viric/smartcitizen-kit-21/hardware/SCK_URBAN_BOARD_2.1/SCK_URBAN_SHIELD_2.1rev_a.sch

## EAGLE design hardware/SCK_URBAN_BOARD_2.1/SCK_URBAN_SHIELD_2.1rev_a.sch (2020-02-14)

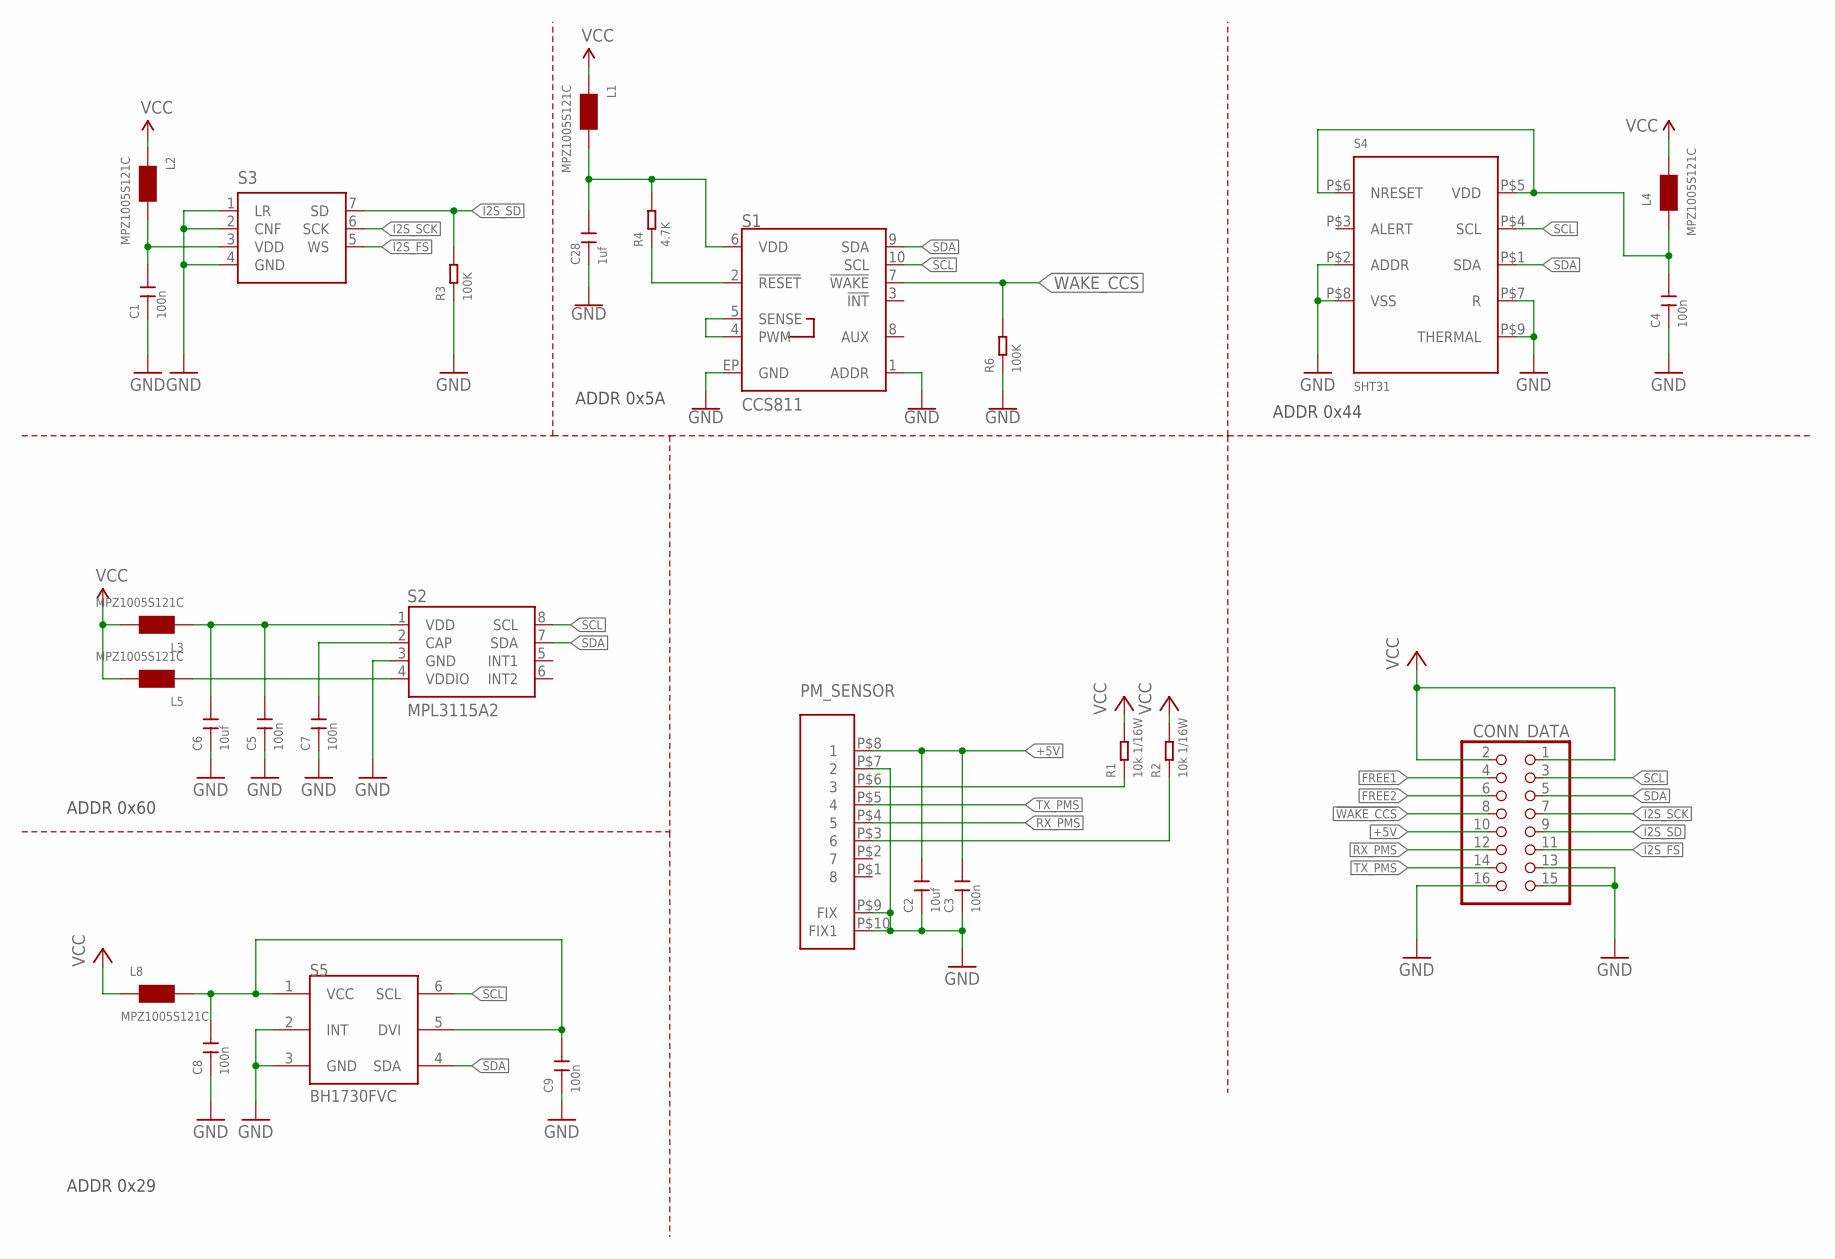
[picture p1: schematic SCK_URBAN_SHIELD_2.1rev_a.sch]

Parts:
C1, C3, C4, C5, C7, C8, C9: 100n; C0402
C2, C6: 10uf; C0603
C28: 1uf; C0805
CONN_DATA: PINHD_2X8MAL_SMD; PINHD_2X8_SMD_MALE_UNHOLED
L1, L2, L3, L4, L5, L8: MPZ1005S121C; 0402
PM_SENSOR: MOLEX_53261-0871_8PIN_RECT; MOLEX_PICOBLADE_90ANGLE_8PIN
R1, R2: 10k 1/16W; R0402
R3, R6: 100K; R0402
R4: 4.7K; R0402
S1: CCS811; LGA10
S2: MPL3115A2
S3: ICS-43432
S4: SHT31; DFN8_STH3X-DIS
S5: BH1730FVC; WSOF6

Connections:
!RST: R4.1, S1.2 (!RESET!)
!WAKE_CCS: CONN_DATA.8, R6.2, S1.7 (!WAKE!)
+5V: C2.2, C3.2, CONN_DATA.10, PM_SENSOR.P$8 (1)
FREE1: CONN_DATA.4
FREE2: CONN_DATA.6
GND: C1.1, C2.1, C3.1, C4.1, C5.1, C6.1, C7.1, C8.1, C9.1, C28.1, CONN_DATA.13, CONN_DATA.15, CONN_DATA.16, PM_SENSOR.P$7 (2), PM_SENSOR.P$9 (FIX), PM_SENSOR.P$10 (FIX1), R3.1, R6.1, S1.1 (ADDR), S1.EP (GND), S2.3 (GND), S3.1 (LR), S3.2 (CNF), S3.4 (GND), S4.P$2 (ADDR), S4.P$7 (R), S4.P$8 (VSS), S4.P$9 (THERMAL), S5.2 (INT), S5.3 (GND)
I2S_FS: CONN_DATA.11, S3.5 (WS)
I2S_SCK: CONN_DATA.7, S3.6 (SCK)
I2S_SD: CONN_DATA.9, R3.2, S3.7 (SD)
unnamed: C7.2, S2.2 (CAP)
unnamed: C8.2, C9.2, L8.2, S5.1 (VCC), S5.5 (DVI)
unnamed: C4.2, L4.2, S4.P$5 (VDD), S4.P$6 (NRESET)
unnamed: C28.2, L1.2, R4.2, S1.6 (VDD)
unnamed: L5.1, S2.4 (VDDIO)
unnamed: C5.2, C6.2, L3.1, S2.1 (VDD)
unnamed: PM_SENSOR.P$6 (3), R1.1
unnamed: PM_SENSOR.P$3 (6), R2.1
unnamed: C1.2, L2.2, S3.3 (VDD)
NTC_SENSE: S1.4 (PWM), S1.5 (SENSE)
RX_PMS: CONN_DATA.12, PM_SENSOR.P$4 (5)
SCL: CONN_DATA.3, S1.10 (SCL), S2.8 (SCL), S4.P$4 (SCL), S5.6 (SCL)
SDA: CONN_DATA.5, S1.9 (SDA), S2.7 (SDA), S4.P$1 (SDA), S5.4 (SDA)
TX_PMS: CONN_DATA.14, PM_SENSOR.P$5 (4)
VCC: CONN_DATA.1, CONN_DATA.2, L1.1, L2.1, L3.2, L4.1, L5.2, L8.1, R1.2, R2.2

Notes on the sheet:
ADDR 0x44
ADDR 0x60
ADDR 0x29
ADDR 0x5A
