viric/smartcitizen-kit-21/sam/src/SckUrban.cpp

#include "SckUrban.h"
#include "SckBase.h"

// Hardware Serial UART PM
Uart SerialPM (&sercom5, pinPM_SERIAL_RX, pinPM_SERIAL_TX, SERCOM_RX_PAD_1, UART_TX_PAD_0);
void SERCOM5_Handler() {
	SerialPM.IrqHandler();
}

bool SckUrban::setup()
{
	if (!sck_bh1730fvc.start()) return false;
	if (!sck_sht31.start()) return false;
	if (!sck_noise.start()) return false;
	if (!sck_mpl3115A2.start()) return false;
	if (!sck_ccs811.start()) return false;
	sck_pm.start(); // This sensor is independent of the urban board. That's way we don't declare error if it's not there.

	return true;
};
bool SckUrban::start(SensorType wichSensor)
{
	switch(wichSensor) {
		case SENSOR_LIGHT: 				if (sck_bh1730fvc.start()) return true; break;
		case SENSOR_TEMPERATURE:
		case SENSOR_HUMIDITY: 				if (sck_sht31.start()) return true; break;
		case SENSOR_NOISE_DBA:
		case SENSOR_NOISE_DBC:
		case SENSOR_NOISE_DBZ:
		case SENSOR_NOISE_FFT: 				if (sck_noise.start()) return true; break;
		case SENSOR_ALTITUDE:
		case SENSOR_PRESSURE:
		case SENSOR_PRESSURE_TEMP: 			if (sck_mpl3115A2.start()) return true; break;
		case SENSOR_CCS811_VOCS:			return sck_ccs811.start(); break;
		case SENSOR_CCS811_ECO2: 			return sck_ccs811.start(); break;
		case SENSOR_PM_1:
		case SENSOR_PM_25:
		case SENSOR_PM_10:
		case SENSOR_PN_03:
		case SENSOR_PN_05:
		case SENSOR_PN_1:
		case SENSOR_PN_25:
		case SENSOR_PN_5:
		case SENSOR_PN_10: 				if (sck_pm.start()) return true; break;
		default: break;
	}

	return false;
}
bool SckUrban::stop(SensorType wichSensor)
{
	switch(wichSensor) {
		case SENSOR_LIGHT: 				if (sck_bh1730fvc.stop()) return true; break;
		case SENSOR_TEMPERATURE:
		case SENSOR_HUMIDITY: 				if (sck_sht31.stop()) return true; break;
		case SENSOR_NOISE_DBA:
		case SENSOR_NOISE_DBC:
		case SENSOR_NOISE_DBZ:
		case SENSOR_NOISE_FFT: 				if (sck_noise.stop()) return true;
		case SENSOR_ALTITUDE:
		case SENSOR_PRESSURE:
		case SENSOR_PRESSURE_TEMP: 			if (sck_mpl3115A2.stop()) return true; break;
		case SENSOR_CCS811_VOCS:			return sck_ccs811.stop(); break;
		case SENSOR_CCS811_ECO2: 			return sck_ccs811.stop(); break;
		case SENSOR_PM_1:
		case SENSOR_PM_25:
		case SENSOR_PM_10:
		case SENSOR_PN_03:
		case SENSOR_PN_05:
		case SENSOR_PN_1:
		case SENSOR_PN_25:
		case SENSOR_PN_5:
		case SENSOR_PN_10: 				if (sck_pm.stop()) return true; break;
		default: break;
	}

	return false;
}

void SckUrban::getReading(SckBase *base, OneSensor *wichSensor)
{
	wichSensor->state = 0;
	switch(wichSensor->type) {
		case SENSOR_LIGHT:			if (sck_bh1730fvc.get()) 			{ wichSensor->reading = String(sck_bh1730fvc.reading); return; } break;
		case SENSOR_TEMPERATURE: 		if (sck_sht31.getReading()) 			{ wichSensor->reading = String(sck_sht31.temperature); return; } break;
		case SENSOR_HUMIDITY: 			if (sck_sht31.getReading()) 			{ wichSensor->reading = String(sck_sht31.humidity); return; } break;
		case SENSOR_NOISE_DBA: 			if (sck_noise.getReading(SENSOR_NOISE_DBA)) 	{ wichSensor->reading = String(sck_noise.readingDB); return; } break;
		case SENSOR_NOISE_DBC: 			if (sck_noise.getReading(SENSOR_NOISE_DBC)) 	{ wichSensor->reading = String(sck_noise.readingDB); return; } break;
		case SENSOR_NOISE_DBZ: 			if (sck_noise.getReading(SENSOR_NOISE_DBZ)) 	{ wichSensor->reading = String(sck_noise.readingDB); return; } break;
		case SENSOR_NOISE_FFT: 			if (sck_noise.getReading(SENSOR_NOISE_FFT)) 	{
								// TODO find a way to give access to readingsFFT instead of storing them on a String (too much RAM)
								// For now it just prints the values to console
								for (uint16_t i=1; i<sck_noise.FFT_NUM; i++) SerialUSB.println(sck_noise.readingFFT[i]);
								return;
							}
		case SENSOR_CCS811_VOCS:		if (sck_ccs811.getReading(base)) 		{ wichSensor->reading = String(sck_ccs811.VOCgas); return; } break;
		case SENSOR_CCS811_ECO2:		if (sck_ccs811.getReading(base)) 		{ wichSensor->reading = String(sck_ccs811.ECO2gas); return; } break;
		case SENSOR_ALTITUDE:			if (sck_mpl3115A2.getAltitude()) 		{ wichSensor->reading = String(sck_mpl3115A2.altitude); return; } break;
		case SENSOR_PRESSURE:			if (sck_mpl3115A2.getPressure()) 		{ wichSensor->reading = String(sck_mpl3115A2.pressure); return; } break;
		case SENSOR_PRESSURE_TEMP:		if (sck_mpl3115A2.getTemperature()) 		{ wichSensor->reading = String(sck_mpl3115A2.temperature); return; } break;
		case SENSOR_PM_1: 			wichSensor->state = sck_pm.oneShot(sck_pm.oneShotPeriod); if (wichSensor->state == -1) break; if (wichSensor->state == 0) wichSensor->reading = String(sck_pm.pm1); return;
		case SENSOR_PM_25: 			wichSensor->state = sck_pm.oneShot(sck_pm.oneShotPeriod); if (wichSensor->state == -1) break; if (wichSensor->state == 0) wichSensor->reading = String(sck_pm.pm25); return;
		case SENSOR_PM_10: 			wichSensor->state = sck_pm.oneShot(sck_pm.oneShotPeriod); if (wichSensor->state == -1) break; if (wichSensor->state == 0) wichSensor->reading = String(sck_pm.pm10); return;
		case SENSOR_PN_03: 			wichSensor->state = sck_pm.oneShot(sck_pm.oneShotPeriod); if (wichSensor->state == -1) break; if (wichSensor->state == 0) wichSensor->reading = String(sck_pm.pn03); return;
		case SENSOR_PN_05: 			wichSensor->state = sck_pm.oneShot(sck_pm.oneShotPeriod); if (wichSensor->state == -1) break; if (wichSensor->state == 0) wichSensor->reading = String(sck_pm.pn05); return;
		case SENSOR_PN_1: 			wichSensor->state = sck_pm.oneShot(sck_pm.oneShotPeriod); if (wichSensor->state == -1) break; if (wichSensor->state == 0) wichSensor->reading = String(sck_pm.pn1); return;
		case SENSOR_PN_25: 			wichSensor->state = sck_pm.oneShot(sck_pm.oneShotPeriod); if (wichSensor->state == -1) break; if (wichSensor->state == 0) wichSensor->reading = String(sck_pm.pn25); return;
		case SENSOR_PN_5: 			wichSensor->state = sck_pm.oneShot(sck_pm.oneShotPeriod); if (wichSensor->state == -1) break; if (wichSensor->state == 0) wichSensor->reading = String(sck_pm.pn5); return;
		case SENSOR_PN_10: 			wichSensor->state = sck_pm.oneShot(sck_pm.oneShotPeriod); if (wichSensor->state == -1) break; if (wichSensor->state == 0) wichSensor->reading = String(sck_pm.pn10); return;
		default: break;
	}
	wichSensor->reading = "null";
	wichSensor->state = -1;
}
bool SckUrban::control(SckBase *base, SensorType wichSensor, String command)
{

	switch (wichSensor) {
		case SENSOR_NOISE_DBA:
		case SENSOR_NOISE_DBC:
		case SENSOR_NOISE_DBZ:
		case SENSOR_NOISE_FFT:
		{
				if (command.startsWith("debug")) {
					sck_noise.debugFlag = !sck_noise.debugFlag;
					sprintf(base->outBuff, "Noise debug: %s", sck_noise.debugFlag  ? "true" : "false");
					base->sckOut();
					return true;
				}
				break;
		}
		case SENSOR_CCS811_VOCS:
		case SENSOR_CCS811_ECO2:
		{
				if (command.startsWith("compensate")) {
					base->config.extra.ccsCompensate = !base->config.extra.ccsCompensate;
					sprintf(base->outBuff, "compensate set to: %s",
                            base->config.extra.ccsCompensate ? "true" : "false");
					base->sckOut();
					return true;
				} else if (command.startsWith("mode")) {
				
					command.replace("mode", "");
					command.trim();

					if (command.length() == 0) {
						sprintf(base->outBuff, "Current drive mode: %u", sck_ccs811.driveMode);
						base->sckOut();
						return "true";
					}

					uint8_t newDriveMode = command.toInt();
					if ((newDriveMode == 0 and !command.equals("0")) || newDriveMode > 4 || newDriveMode < 0) return F("Wrong drive mode value received, try again");

					//Mode 0 = Idle
					//Mode 1 = read every 1s
					//Mode 2 = every 10s
					//Mode 3 = every 60s
					//Mode 4 = RAW mode
					if (sck_ccs811.setDriveMode(newDriveMode) != CCS811Core::CCS811_Stat_SUCCESS) return F("Failed to set new drive mode");
					else return String F("Drivemode set to ") + String(sck_ccs811.driveMode);
					
				} else if (command.startsWith("baseline")) {
					command.replace("baseline", "");
					command.trim();

					uint16_t newbaseline = strtol(command.c_str(), 0, 16);
					bool ok = sck_ccs811.setBaseline(newbaseline);
					if (ok) {
						sprintf(base->outBuff, "New baseline set: 0x%x", newbaseline);
						base->sckOut();
					} else {
						sprintf(base->outBuff, "Error setting baseline: 0x%x", newbaseline);
						base->sckOut();
					}
					return true;
				} else if (command.startsWith("status")) {
					uint8_t major, minor, trivial;
					bool ok = sck_ccs811.getFWAppVersion(&major, &minor, &trivial);
					if (ok) {
						sprintf(base->outBuff, "fw app version: %u.%u.%u",
								major, minor, trivial);
						base->sckOut();
					} else {
						sprintf(base->outBuff, "fw app version: failed");
						base->sckOut();
					}
					sprintf(base->outBuff, "mode: %i",
                            sck_ccs811.driveMode);
					base->sckOut();
					sprintf(base->outBuff, "run-in passed: %s",
							base->getRuninPassed() ? "true":"false");
					base->sckOut();
					sprintf(base->outBuff, "getBaseline: 0x%hx",
                            sck_ccs811.getBaseline());
					base->sckOut();
					uint8_t errorcode;
					bool statusError = sck_ccs811.getStatusError(&errorcode);
					if (statusError) {
						sprintf(base->outBuff, "status error: error 0x%x",
								errorcode);
						base->sckOut();
					} else {
						sprintf(base->outBuff, "status error: no error");
						base->sckOut();
					}

					sprintf(base->outBuff, "compensate: %s",
							base->config.extra.ccsCompensate ? "true" : "false");
					base->sckOut();
					return true;
				} else if (command.startsWith("help") || command.length() == 0) {
				
					sprintf(base->outBuff, "Available commands:\r\n"
                            "* compensate (toggles temp/hum compensation)\r\n"
                            "* mode [0-4] (0-idle, 1-1s, 2-10s, 3-60s, 4-raw)\r\n"
                            "* baseline XXXX (set baseline to hex num)\r\n"
                            "* status");
					base->sckOut();
					return true;
				}
			break;
		}
		default: break;
	}

	base->sckOut("Sensor not recognized!!");
	return false;
}

// Light
bool Sck_BH1730FVC::start()
{
	if (!I2Cdetect(&Wire, address)) return false;
	return true;
}
bool Sck_BH1730FVC::stop()
{
	// 0x00 register - CONTROL
	uint8_t CONTROL = B000000;
	// ADC_INTR: 	5	0:Interrupt is inactive.
	// 			1:Interrupt is active.
	// ADC_VALID:	4	0:ADC data is not updated after last reading.
	// 			1:ADC data is updated after last reading.
	// ONE_TIME:	3	0:ADC measurement is continuous.
	// 			1:ADC measurement is one time.
	// 			ADC	transits to power down automatically.
	// DATA_SEL:	2	0:ADC measurement Type0 and Type1.
	// 			1:ADC measurement Type0 only.
	// ADC_EN:	1	0:ADC measurement stop.
	// 			1:ADC measurement start.
	// POWER:	0	0:ADC power down.
	// 			1:ADC power on.

	// Send Configuration
	// This will save around 150 uA
	Wire.beginTransmission(address);
	Wire.write(0x80);
	Wire.write(CONTROL);
	Wire.endTransmission();

	return true;
}
bool Sck_BH1730FVC::updateValues()
{
	// Datasheet http://rohmfs.rohm.com/en/products/databook/datasheet/ic/sensor/light/bh1730fvc-e.pdf

	// 0x00 register - CONTROL
	uint8_t CONTROL = B000011;
	// ADC_INTR: 	5	0:Interrupt is inactive.
	// 			1:Interrupt is active.
	// ADC_VALID:	4	0:ADC data is not updated after last reading.
	// 			1:ADC data is updated after last reading.
	// ONE_TIME:	3	0:ADC measurement is continuous.
	// 			1:ADC measurement is one time.
	// 			ADC	transits to power down automatically.
	// DATA_SEL:	2	0:ADC measurement Type0 and Type1.
	// 			1:ADC measurement Type0 only.
	// ADC_EN:	1	0:ADC measurement stop.
	// 			1:ADC measurement start.
	// POWER:	0	0:ADC power down.
	// 			1:ADC power on.

	// 0x01 register - TIMMING
	// uint8_t ITIME  = 0xDA; 	// Datasheet default value (218 DEC)

	// 00h: Start / Stop of measurement is set by special command. (ADC manual integration mode)
	// 01h to FFh: Integration time is determined by ITIME value (defaultt is oxDA)
	// Integration Time : ITIME_ms = Tint * 964 * (256 - ITIME)
	// Measurement time : Tmt= ITIME_ms + Tint * 714

	// 0x02 register - INTERRUPT
	uint8_t INTERRUPT = B00000000;
	// RES 		7 	Write 0
	// INT_STOP	6	0 : ADC measurement does not stop.
	// 				1 : ADC measurement stops and transits to power down mode when interrupt becomes active.
	// RES 		5 	Write 0
	// INT_EN 	4 	0 : Disable interrupt function.
	// 				1 : Enable interrupt function.
	// PERSIST 	3:0 Interrupt persistence function.
	//	0000 : Interrupt becomes active at each measurement end.
	//	0001 : Interrupt status is updated at each measurement end.
	//	0010 : Interrupt status is updated if two consecutive threshold judgments are the same.
	//	When  set  0011  or  more,  interrupt  status  is  updated  if same threshold judgments continue consecutively same times as the number set in PERSIST.

	// 0x03, 0x04 registers - TH_LOW Low interrupt threshold
	uint8_t TH_LOW0 = 0x00;		// Lower byte of low interrupt threshold
	uint8_t TH_LOW1 = 0x00;		// Upper byte of low interrupt threshold

	// 0x05, 0x06 registers - TH_UP High interrupt threshold
	uint8_t TH_UP0 = 0xFF;		// Lower byte of high interrupt threshold
	uint8_t TH_UP1 = 0xFF;		// Upper byte of high interrupt threshold

	// 0x07 - GAIN
	uint8_t GAIN = 0x00;
	// GAIN  2:0	ADC resolution setting
	//	  X00 : x1 gain mode
	//	  X01 : x2 gain mode
	//	  X10 : x64 gain mode
	//	  X11 : x128 gain mode

	uint8_t DATA[8] = {CONTROL, ITIME, INTERRUPT, TH_LOW0, TH_LOW1, TH_UP0, TH_UP1, GAIN};

	// Send Configuration
	Wire.beginTransmission(address);
	Wire.write(0x80);
	for (int i= 0; i<8; i++) Wire.write(DATA[i]);
	Wire.endTransmission();

	// Calculate timming values
	ITIME_ms = (Tint * 964 * (256 - ITIME)) / 1000;
	Tmt =  ITIME_ms + (Tint * 714);

	// Wait for ADC to finish
	uint32_t started = millis();
	uint8_t answer = 0;
	while ((answer & 0x10) == 0) {
		delay(10);
		Wire.beginTransmission(address);
		Wire.write(0x80);
		Wire.endTransmission();
		Wire.requestFrom(address, 1);
		answer = Wire.read();
		if (millis() - started > Tmt) {
			if (debug) SerialUSB.println("ERROR: Timeout waiting for reading");
			return false;
		}
	}

	// Ask for reading
	Wire.beginTransmission(address);
	Wire.write(0x94);
	Wire.endTransmission();
	Wire.requestFrom(address, 4);

	// Get result
	uint16_t IDATA0 = 0;
	uint16_t IDATA1 = 0;
	IDATA0 = Wire.read();
	IDATA0 = IDATA0 | (Wire.read()<<8);
	IDATA1 = Wire.read();
	IDATA1 = IDATA1 | (Wire.read()<<8);
	DATA0 = (float)IDATA0;
	DATA1 = (float)IDATA1;

	// Setup gain
	Gain = 1;
	if (GAIN == 0x01) Gain = 2;
	else if (GAIN == 0x02) Gain = 64;
	else if (GAIN == 0x03) Gain = 128;

	return true;
}
bool Sck_BH1730FVC::get()
{
	// Start in the default integration time
	ITIME = 218;

	if (!updateValues()) return false;

	// Adjust the Integration Time (ITIME)
	for (uint8_t i=0; i<6; i++) {

		if (DATA0 > goUp || DATA1 > goUp) {
			ITIME += (((ITIME_max - ITIME) / 2) + 1);
			if (ITIME > 250) ITIME = ITIME_max;

			if (debug) {
				SerialUSB.print(DATA0);
				SerialUSB.print(" -- ");
				SerialUSB.print(DATA1);
				SerialUSB.print(" >> ");
				SerialUSB.println(ITIME);
			}
		} else break;

		if (!updateValues()) return false;
	}

	// Lux calculation (Datasheet page 13)
	float Lx = 0;
	if (DATA0 > 0 && DATA1 > 0) {
		if (DATA1/DATA0 < 0.26) Lx = ((1.290 * DATA0 - 2.733 * DATA1) / Gain) * (102.6 / ITIME_ms);
		else if (DATA1/DATA0 < 0.55) Lx = ((0.795 * DATA0 - 0.859 * DATA1) / Gain) * (102.6 / ITIME_ms);
		else if (DATA1/DATA0 < 1.09) Lx = ((0.510 * DATA0 - 0.345 * DATA1) / Gain) * (102.6 / ITIME_ms);
		else if (DATA1/DATA0 < 2.13) Lx = ((0.276 * DATA0 - 0.130 * DATA1) / Gain) * (102.6 / ITIME_ms);
		else Lx = 0;
	}

	Lx = max(0, Lx);
	reading  = (int)Lx;

	if (debug) {
		SerialUSB.print("Integration Time ITIME_ms: ");
		SerialUSB.println(ITIME_ms);
		SerialUSB.print("Measurement Time Tmt: ");
		SerialUSB.println(Tmt);
		SerialUSB.print("Gain: ");
		SerialUSB.println(Gain);
		SerialUSB.print("Visible Light DATA0: ");
		SerialUSB.println(DATA0);
		SerialUSB.print("Infrared Light DATA1: ");
		SerialUSB.println(DATA1);
		SerialUSB.print("Calculated Lux: ");
		SerialUSB.println(Lx);
	}

	stop();

	return true;
}

// SHT31 (Temperature and Humidity)
// TODO Implement calibration routine
// TODO implement heater controller
Sck_SHT31::Sck_SHT31(TwoWire *localWire)
{
	_Wire = localWire;
}
bool Sck_SHT31::start()
{
	_Wire->begin();
	_Wire->beginTransmission(address);
	byte error = _Wire->endTransmission();
	if (error != 0) return false;

	delay(1); 		// In case the device was off
	sendComm(SOFT_RESET); 	// Send reset command
	delay(50); 		// Give time to finish reset
	update();

	return true;
}
bool Sck_SHT31::stop()
{

	// It will go to idle state by itself after 1ms
	return true;
}
bool Sck_SHT31::update()
{
	uint8_t readbuffer[6];
	if (!sendComm(SINGLE_SHOT_HIGH_REP)) return false;

	uint32_t started = millis();
	while (_Wire->requestFrom(address, 6) < 6) {
		if (millis() - started > timeout) {
			if (debug) SerialUSB.println("ERROR: Timed out waiting for SHT31 sensor!!!");
			return false;
		}
	}

	// Read response
	if (debug) SerialUSB.print("Response: ");
	for (uint8_t i=0; i<6; i++) {
		readbuffer[i] = _Wire->read();
		if (debug) SerialUSB.print(readbuffer[i]);
	}
	if (debug) SerialUSB.println();

	uint16_t ST, SRH;
	ST = readbuffer[0];
	ST <<= 8;
	ST |= readbuffer[1];

	// Check Temperature crc
	if (readbuffer[2] != crc8(readbuffer, 2)) {
		if (debug) SerialUSB.println("ERROR: Temperature reading CRC failed!!!");
		return false;
	}
	SRH = readbuffer[3];
	SRH <<= 8;
	SRH |= readbuffer[4];

	// check Humidity crc
	if (readbuffer[5] != crc8(readbuffer+3, 2)) {
		if (debug) SerialUSB.println("ERROR: Humidity reading CRC failed!!!");
		return false;
	}

	double temp = ST;
	temp *= 175;
	temp /= 0xffff;
	temp = -45 + temp;
	temperature = (float)temp;

	double shum = SRH;
	shum *= 100;
	shum /= 0xFFFF;
	humidity = (float)shum;

	return true;
}
bool Sck_SHT31::sendComm(uint16_t comm)
{
	_Wire->beginTransmission(address);
	_Wire->write(comm >> 8);
	_Wire->write(comm & 0xFF);
	if (_Wire->endTransmission() != 0) return false;

	return true;
}
uint8_t Sck_SHT31::crc8(const uint8_t *data, int len)
{

	/* CRC-8 formula from page 14 of SHT spec pdf */

	/* Test data 0xBE, 0xEF should yield 0x92 */

	/* Initialization data 0xFF */
	/* Polynomial 0x31 (x8 + x5 +x4 +1) */
	/* Final XOR 0x00 */

	const uint8_t POLYNOMIAL(0x31);
	uint8_t crc(0xFF);

	for ( int j = len; j; --j ) {
		crc ^= *data++;
		for ( int i = 8; i; --i ) {
			crc = ( crc & 0x80 )
				? (crc << 1) ^ POLYNOMIAL
				: (crc << 1);
		}
	}
	return crc;
}
bool Sck_SHT31::getReading()
{
	uint8_t tried = retrys;
	while (tried > 0) {
		if (update()) return true;
		tried--;
	}

	return false;
}

// Noise
bool Sck_Noise::start()
{
	if (alreadyStarted) return true;

	REG_GCLK_GENCTRL = GCLK_GENCTRL_ID(4);  // Select GCLK4
	while (GCLK->STATUS.bit.SYNCBUSY);

	alreadyStarted = true;
	return true;
}
bool Sck_Noise::stop()
{
	return true;
}
bool Sck_Noise::getReading(SensorType wichSensor)
{
	if (!I2S.begin(I2S_PHILIPS_MODE, sampleRate, 32)) return false;

	// Wait 263000 I2s cycles or 85 ms at 441000 hz
	uint32_t startPoint = millis();
	while (millis() - startPoint < 100) I2S.read();

	// Fill buffer with samples from I2S bus
	int32_t source[SAMPLE_NUM];
	uint16_t bufferIndex = 0;

	startPoint = millis();
	uint8_t timeOut = 30; 	// (ms) Timeout to avoid hangs if the I2S is not responfing
	while (bufferIndex < SAMPLE_NUM) {
		int32_t buff = I2S.read();
		if (buff) {
			source[bufferIndex] = buff>>7;
			bufferIndex ++;
		}

		if (millis() - startPoint > timeOut) {
			I2S.end();
			return false;
		}
	}
	I2S.end();

	// Get de average of recorded samples
	int32_t sum = 0;
	for (uint16_t i=0; i<SAMPLE_NUM; i++) sum += source[i];
	int32_t avg = sum / SAMPLE_NUM;

	// Center samples in zero
	for (uint16_t i=0; i<SAMPLE_NUM; i++) source[i] = source[i] - avg;

	// FFT
	FFT(source);

	switch(wichSensor) {

		case SENSOR_NOISE_DBA:
			// Equalization and A weighting
			for (uint16_t i=0; i<FFT_NUM; i++) readingFFT[i] *= (double)(equalWeight_A[i] / 65536.0);
			break;
		case SENSOR_NOISE_DBC:
			// Equlization and C weighting
			for (uint16_t i=0; i<FFT_NUM; i++) readingFFT[i] *= (double)(equalWeight_C[i] / 65536.0);
			break;
		case SENSOR_NOISE_DBZ:
			// Just Equalization
			for (uint16_t i=0; i<FFT_NUM; i++) readingFFT[i] *= (double)(equalTab[i] / 65536.0);
			break;
		case SENSOR_NOISE_FFT:
			// Convert FFT to dB
			fft2db();
			return true;
			break;
		default: break;
	}

	// RMS
	long long rmsSum = 0;
	double rmsOut = 0;
	for (uint16_t i=0; i<FFT_NUM; i++) rmsSum += pow(readingFFT[i], 2) / FFT_NUM;
	rmsOut = sqrt(rmsSum);
	rmsOut = rmsOut * 1 / RMS_HANN * sqrt(FFT_NUM) / sqrt(2);

	// Convert to dB
	readingDB = (double) (FULL_SCALE_DBSPL - (FULL_SCALE_DBFS - (20 * log10(rmsOut * sqrt(2)))));

	if (debugFlag) {
		SerialUSB.println("samples, FFT_weighted");
		for (uint16_t i=0; i<SAMPLE_NUM; i++) {
			SerialUSB.print(source[i]);
			SerialUSB.print(",");
			if (i < 256) SerialUSB.println(readingFFT[i]);
			else SerialUSB.println();
		}
	}

	return true;
}
bool Sck_Noise::FFT(int32_t *source)
{
	int16_t scaledSource[SAMPLE_NUM];
	double divider = dynamicScale(source, scaledSource);

	applyWindow(scaledSource, hannWindow, SAMPLE_NUM);

	static int16_t ALIGN4 scratchData[SAMPLE_NUM * 2];

	// Split the data
	for(int i=0; i<SAMPLE_NUM*2; i+=2){
		scratchData[i] = scaledSource[i/2]; // Real
		scratchData[i+1] = 0; // Imaginary
	}

	arm_radix2_butterfly(scratchData, (int16_t)SAMPLE_NUM, (int16_t *)twiddleCoefQ15_512);
	arm_bitreversal(scratchData, SAMPLE_NUM, (uint16_t *)armBitRevTable8);

	for (int i=0; i<SAMPLE_NUM/2; i++) {

		// Calculate result and normalize SpectrumBuffer, also revert dynamic scaling
		uint32_t myReal = pow(scratchData[i*2], 2);
		uint32_t myImg = pow(scratchData[(i*2)+1], 2);

		readingFFT[i] = sqrt(myReal + myImg) * divider * 4;
	}

	// Exception for the first bin
	readingFFT[0] = readingFFT[0] / 2;

	return 0;
}
double Sck_Noise::dynamicScale(int32_t *source, int16_t *scaledSource)
{
	int32_t maxLevel = 0;
	for (uint16_t i=0; i<SAMPLE_NUM; i++) if (abs(source[i]) > maxLevel) maxLevel = abs(source[i]);
	double divider = (maxLevel+1) / 32768.0; // 16 bits
	if (divider < 1) divider = 1;

	for (uint16_t i=0; i<SAMPLE_NUM; i++) scaledSource[i] = source[i] / divider;

	return divider;
}
void Sck_Noise::applyWindow(int16_t *src, const uint16_t *window, uint16_t len)
{
	/* This code is from https://github.com/adafruit/Adafruit_ZeroFFT thank you!
		-------
		This is an FFT library for ARM cortex M0+ CPUs
		Adafruit invests time and resources providing this open source code,
		please support Adafruit and open-source hardware by purchasing products from Adafruit!
		Written by Dean Miller for Adafruit Industries. MIT license, all text above must be included in any redistribution
		------
	*/

	while(len--){
		int32_t val = *src * *window++;
		*src = val >> 15;
		src++;
	}
}
void Sck_Noise::arm_radix2_butterfly(int16_t * pSrc, int16_t fftLen, int16_t * pCoef)
{
	/* This code is from https://github.com/adafruit/Adafruit_ZeroFFT thank you!
		-------
		This is an FFT library for ARM cortex M0+ CPUs
		Adafruit invests time and resources providing this open source code,
		please support Adafruit and open-source hardware by purchasing products from Adafruit!
		Written by Dean Miller for Adafruit Industries. MIT license, all text above must be included in any redistribution
		------
	*/

	int i, j, k, l;
	int n1, n2, ia;
	int16_t xt, yt, cosVal, sinVal;

	n2 = fftLen;

	n1 = n2;
	n2 = n2 >> 1;
	ia = 0;

	// loop for groups
	for (j=0; j<n2; j++) {
		cosVal = pCoef[ia * 2];
		sinVal = pCoef[(ia * 2) + 1];
		ia++;

		// loop for butterfly
		for (i=j; i<fftLen; i+=n1) {
			l = i + n2;
			xt = (pSrc[2 * i] >> 2u) - (pSrc[2 * l] >> 2u);
			pSrc[2 * i] = ((pSrc[2 * i] >> 2u) + (pSrc[2 * l] >> 2u)) >> 1u;

			yt = (pSrc[2 * i + 1] >> 2u) - (pSrc[2 * l + 1] >> 2u);
			pSrc[2 * i + 1] =
				((pSrc[2 * l + 1] >> 2u) + (pSrc[2 * i + 1] >> 2u)) >> 1u;

			pSrc[2u * l] = (((int16_t) (((int32_t) xt * cosVal) >> 16)) +
					((int16_t) (((int32_t) yt * sinVal) >> 16)));

			pSrc[2u * l + 1u] = (((int16_t) (((int32_t) yt * cosVal) >> 16)) -
					((int16_t) (((int32_t) xt * sinVal) >> 16)));

		}                           // butterfly loop end
	}                             // groups loop end

	uint16_t twidCoefModifier = 2;

	// loop for stage
	for (k = fftLen / 2; k > 2; k = k >> 1) {
		n1 = n2;
		n2 = n2 >> 1;
		ia = 0;

		// loop for groups
		for (j=0; j<n2; j++) {
			cosVal = pCoef[ia * 2];
			sinVal = pCoef[(ia * 2) + 1];

			ia = ia + twidCoefModifier;

			// loop for butterfly
			for (i=j; i<fftLen; i+=n1) {
				l = i + n2;
				xt = pSrc[2 * i] - pSrc[2 * l];
				pSrc[2 * i] = (pSrc[2 * i] + pSrc[2 * l]) >> 1u;

				yt = pSrc[2 * i + 1] - pSrc[2 * l + 1];
				pSrc[2 * i + 1] = (pSrc[2 * l + 1] + pSrc[2 * i + 1]) >> 1u;

				pSrc[2u * l] = (((int16_t) (((int32_t) xt * cosVal) >> 16)) +
						((int16_t) (((int32_t) yt * sinVal) >> 16)));

				pSrc[2u * l + 1u] = (((int16_t) (((int32_t) yt * cosVal) >> 16)) -
						((int16_t) (((int32_t) xt * sinVal) >> 16)));

			}                         // butterfly loop end
		}                           // groups loop end
		twidCoefModifier = twidCoefModifier << 1u;
	}                             // stages loop end

	n1 = n2;
	n2 = n2 >> 1;
	ia = 0;
	// loop for groups
	for (j=0; j<n2; j++) {
		cosVal = pCoef[ia * 2];
		sinVal = pCoef[(ia * 2) + 1];

		ia = ia + twidCoefModifier;

		// loop for butterfly
		for (i=j; i<fftLen; i+=n1) {
			l = i + n2;
			xt = pSrc[2 * i] - pSrc[2 * l];
			pSrc[2 * i] = (pSrc[2 * i] + pSrc[2 * l]);

			yt = pSrc[2 * i + 1] - pSrc[2 * l + 1];
			pSrc[2 * i + 1] = (pSrc[2 * l + 1] + pSrc[2 * i + 1]);

			pSrc[2u * l] = xt;

			pSrc[2u * l + 1u] = yt;

		}                           // butterfly loop end
	}                             // groups loop end
}
void Sck_Noise::arm_bitreversal(int16_t * pSrc16, uint32_t fftLen, uint16_t * pBitRevTab)
{
	/* This code is from https://github.com/adafruit/Adafruit_ZeroFFT thank you!
		-------
		This is an FFT library for ARM cortex M0+ CPUs
		Adafruit invests time and resources providing this open source code,
		please support Adafruit and open-source hardware by purchasing products from Adafruit!
		Written by Dean Miller for Adafruit Industries. MIT license, all text above must be included in any redistribution
		------
	*/

	int32_t *pSrc = (int32_t *) pSrc16;
	int32_t in;
	uint32_t fftLenBy2, fftLenBy2p1;
	uint32_t i, j;

	/*  Initializations */
	j = 0u;
	fftLenBy2 = fftLen / 2u;
	fftLenBy2p1 = (fftLen / 2u) + 1u;

	/* Bit Reversal Implementation */
	for (i = 0u; i <= (fftLenBy2 - 2u); i += 2u) {
		if(i < j) {
			in = pSrc[i];
			pSrc[i] = pSrc[j];
			pSrc[j] = in;

			in = pSrc[i + fftLenBy2p1];
			pSrc[i + fftLenBy2p1] = pSrc[j + fftLenBy2p1];
			pSrc[j + fftLenBy2p1] = in;
		}

		in = pSrc[i + 1u];
		pSrc[i + 1u] = pSrc[j + fftLenBy2];
		pSrc[j + fftLenBy2] = in;

		/*  Reading the index for the bit reversal */
		j = *pBitRevTab;

		/*  Updating the bit reversal index depending on the fft length  */
		pBitRevTab++;
	}
}
void Sck_Noise::fft2db()
{
	for (uint16_t i=0; i<FFT_NUM; i++) {
		if (readingFFT[i] > 0) readingFFT[i] = FULL_SCALE_DBSPL - (FULL_SCALE_DBFS - (20 * log10(readingFFT[i] * sqrt(2))));
		if (readingFFT[i] < 0) readingFFT[i] = 0;
	}
}

// Barometric pressure and Altitude
bool Sck_MPL3115A2::start()
{
	if (!I2Cdetect(&Wire, address)) return false;
	if (Adafruit_mpl3115A2.begin()) return true;
	return false;
}
bool Sck_MPL3115A2::stop()
{

	return true;
}
bool Sck_MPL3115A2::getAltitude()
{

	Adafruit_mpl3115A2.begin();

	// TODO callibration with control interface
	// Maybe we could implement get online data to calibrate this
	// mpl3115A2.setSeaPressure(102250.0);

	// TODO timeout to prevent hangs on external lib
	altitude = Adafruit_mpl3115A2.getAltitude();

	return true;
}
bool Sck_MPL3115A2::getPressure()
{

	Adafruit_mpl3115A2.begin();

	// TODO timeout to prevent hangs on external lib
	pressure = Adafruit_mpl3115A2.getPressure() / 1000;

	return true;
}
bool Sck_MPL3115A2::getTemperature()
{

	Adafruit_mpl3115A2.begin();

	// TODO timeout to prevent hangs on external lib
	altitude = Adafruit_mpl3115A2.getAltitude();
	temperature =  Adafruit_mpl3115A2.getTemperature();	// Only works after a getAltitude! don't call this allone

	return true;
}

// PM sensor
bool Sck_PM::start()
{
	if (started) return true;
	if (detectionFailed) return false;

	pinMode(pinPM_ENABLE, OUTPUT);
	digitalWrite(pinPM_ENABLE, HIGH);
	SerialPM.begin(9600);

	uint32_t startTimer = millis();
	while (millis() - startTimer < 4000) {
		delay(50);
		if (SerialPM.available()) {
			started = true;
			rtcStarted = rtc->getEpoch();
			return true;
		}
	}
	stop();
	detectionFailed = true;
	return false;
}
bool Sck_PM::stop()
{
	digitalWrite(pinPM_ENABLE, LOW);
	SerialPM.end();
	started = false;
	rtcStopped = rtc->getEpoch();
	detectionFailed = false;

	return true;
}
bool Sck_PM::update()
{
	if (millis() - lastReading < 1000) return true; 	// PM sensor only delivers one reading per second
	if (millis() - lastFail < 1000) return false; 		// We need at least one second after las fail

	// Empty serial buffer
	while(SerialPM.available()) SerialPM.read();

	// Wait for new readings
	uint32_t startPoint = millis();
	while(SerialPM.available() < (buffLong + 2)) {
		if (millis() - startPoint > 1500) {
			// Timeout
			lastFail = millis();

			// After 10 seconds declare the PM innactive
			if (millis() - lastReading < 10000) {
				active = false;
			}
			return false;
		}
	}


	uint16_t sum = 0;

	// Search for start char 1
	byte sc1 = 0;
	startPoint = millis();
	while (sc1 != 0x42) {
		sc1 = SerialPM.read();
		if (millis() - startPoint > 1500) return false;
	}
	sum += sc1;

	// Confirm we receive start char 2
	byte sc2 = 0;
	sc2 = SerialPM.read();

	if (sc2 == 0x4d) {

		rtcReading = rtc->getEpoch();

		sum += sc2;

		unsigned char buff[buffLong];
		byte howMany =  SerialPM.readBytes(buff, buffLong);

		// Is buffer complete?
		if (howMany < 30) {
			return false;
		}

		// Checksum
		uint16_t checkSum = (buff[28]<<8) + buff[29];
		for(int i=0; i<(buffLong - 2); i++) sum += buff[i];
		if(sum != checkSum) {
			return false;
		}

		// Get the values
		pm1 = (buff[2]<<8) + buff[3];
		pm25 = (buff[4]<<8) + buff[5];
		pm10 = (buff[6]<<8) + buff[7];
		pn03 = (buff[14]<<8) + buff[15];
		pn05 = (buff[16]<<8) + buff[17];
		pn1 = (buff[18]<<8) + buff[19];
		pn25 = (buff[20]<<8) + buff[21];
		pn5 = (buff[22]<<8) + buff[23];
		pn10 = (buff[24]<<8) + buff[25];

		lastReading = millis();
		lastFail = 0;
		active = true;

		return true;
	}
	return false;
}
int16_t Sck_PM::oneShot(uint16_t period)
{
	int16_t pendingSeconds = period;
	uint32_t rtcNow = rtc->getEpoch();

	if (detectionFailed) return -1;
	if (!started) {

		// If last PM reading is older than some time, start PM
		if (rtcNow - rtcReading >= (minimal_reading_interval - period)) {
			stop();  // Be sure it is stoped...
			start();
		}

		// Or... reading is ready
		else pendingSeconds = 0;

	} else {

		pendingSeconds = period - (rtcNow - rtcStarted);

		// Fix the problem generated by updating RTC after starting the PM sensor
		if (pendingSeconds > period) rtcStarted = rtcNow;

		// If PM is on and requested period has passed
		if (pendingSeconds <= 0) {

			// Get reading
			if (update()) {

				// Stop PM, reading is ready
				stop();
				pendingSeconds = 0;

			} else {

				// return Error
				return -1;
			}
		}
	}

	return (int16_t)pendingSeconds;
}
bool Sck_PM::reset()
{
	digitalWrite(pinPM_ENABLE, LOW);
	delay(200);
	digitalWrite(pinPM_ENABLE, HIGH);
	return true;
}

// VOC and ECO2
bool Sck_CCS811::start()
{
	if (alreadyStarted) return true;

	if (!ccs.begin()) return false;

	if (ccs.setDriveMode(driveMode) != CCS811Core::CCS811_Stat_SUCCESS) return false;

	startTime = rtc->getEpoch();
	alreadyStarted = true;
	return true;
}
bool Sck_CCS811::stop()
{
	// If the sensor is not there we don't need to stop it
	if (!I2Cdetect(&Wire, address)) return true;

	if (ccs.setDriveMode(0) != CCS811Core::CCS811_Stat_SUCCESS) return false;
	alreadyStarted = false;
	startTime = 0;
	return true;
}
bool Sck_CCS811::getReading(SckBase *base)
{
	if (!alreadyStarted) start();
	uint32_t rtcNow = rtc->getEpoch();
	if (((startTime == 0) || ((rtcNow - startTime) < warmingTime)) && !base->inTest) {
		if (debug) {
			SerialUSB.println("CCS811: in warming period!!");
			SerialUSB.print("CCS811: Readings will be ready in (sec): ");
			SerialUSB.println(warmingTime - (rtcNow - startTime));
		}
		return false;
	}
	if (millis() - lastReadingMill < 5000) {
		if (debug) SerialUSB.println("CCS811: (not enough time passed)");
		return true; // This prevents getting different updates for ECO2 and VOCS
	}

	if (!ccs.dataAvailable()) {
		uint32_t Uinterval = 60000; 	// Interval between sensor update (ms)
		switch (driveMode) {
			case 1: Uinterval = 1000; break;
			case 2: Uinterval = 10000; break;
			case 3: Uinterval = 60000; break;
		}

		if (debug) {
			SerialUSB.print("CCS811: Drivemode interval (ms): ");
			SerialUSB.println(Uinterval);
		}

		if (millis() - lastReadingMill < Uinterval) {
			if (debug) SerialUSB.println("CCS811: using old readings (not enough time passed)");
			return true;  // We will use last reading because  sensor is not programmed to give us readings so often
		}
		if (debug) SerialUSB.println("CCS811: ERROR obtaining reading!!");
		return false;
	}

	lastReadingMill = millis();

	ccs.readAlgorithmResults();

	VOCgas = ccs.getTVOC();
	ECO2gas = ccs.getCO2();

	if (base->config.extra.ccsCompensate) {
		if (base->sensors[SENSOR_TEMPERATURE].enabled && base->sensors[SENSOR_HUMIDITY].enabled) {
			base->getReading(&base->sensors[SENSOR_HUMIDITY]);
			base->getReading(&base->sensors[SENSOR_TEMPERATURE]);
			if (base->sensors[SENSOR_HUMIDITY].state == 0 && base->sensors[SENSOR_TEMPERATURE].state == 0) {
				if (debug) SerialUSB.println("CCS811: Compensating readings with temp/hum");
				ccs.setEnvironmentalData(base->sensors[SENSOR_HUMIDITY].reading.toFloat(), base->sensors[SENSOR_TEMPERATURE].reading.toFloat());
			} else {
				if (debug) SerialUSB.println("CCS811: Compensation failed Error obtaining temp/hum readings!!");
			}
		} else {
			if (debug) SerialUSB.println("CCS811: temp/hum compensation failed, some sensors are disabled");
		}
	} else {
		if (debug) SerialUSB.println("CCS811: temp/hum compensation is disabled!");
	}
	return true;
}
uint16_t Sck_CCS811::getBaseline()
{
	if (!alreadyStarted) {
		if (!start()) return 0;
	}
	return ccs.getBaseline();
}
bool Sck_CCS811::getStatusError(uint8_t *errorcode)
{
	if (!alreadyStarted) {
		if (!start()) return 0;
	}
	if (ccs.checkForStatusError())
	{
		*errorcode = ccs.getErrorRegister();
		return true;
	}
	return false;
}
bool Sck_CCS811::setBaseline(uint16_t wichBaseline)
{
	if (!alreadyStarted) {
		if (!start()) return false;
	}
	if (ccs.setBaseline(wichBaseline) != ccs.CCS811_Stat_SUCCESS) return false;
	return true;
}
bool Sck_CCS811::setDriveMode(uint8_t wichDrivemode)
{
	driveMode = wichDrivemode;
	if (ccs.setDriveMode(driveMode) != CCS811Core::CCS811_Stat_SUCCESS) return false;
	return true;
}

bool Sck_CCS811::getFWAppVersion(uint8_t *major, uint8_t *minor, uint8_t *trivial)
{
	uint8_t version[2];
	CCS811Core::CCS811_Status_e returnError = 
		ccs.multiReadRegister(CSS811_FW_APP_VERSION, version, sizeof version);
	if (returnError != CCS811Core::CCS811_Stat_SUCCESS)
		return false;
	*major = (version[0] >> 4) & 0xf;
	*minor = version[0] & 0xf;
	*trivial = version[1];
	return true;
}
