viric/smartcitizen-kit-21/sam/src/SckAux.cpp

#include "SckAux.h"

GasesBoard		gasBoard;
GrooveI2C_ADC		grooveI2C_ADC;
INA219			ina219;
Groove_OLED		groove_OLED;
WaterTemp_DS18B20 	waterTemp_DS18B20;
Atlas			atlasPH = Atlas(SENSOR_ATLAS_PH);
Atlas			atlasEC = Atlas(SENSOR_ATLAS_EC);
Atlas			atlasDO = Atlas(SENSOR_ATLAS_DO);
Atlas 			atlasTEMP = Atlas(SENSOR_ATLAS_TEMPERATURE);
Moisture 		moistureChirp;
PMsensor		pmSensor = PMsensor();
PM_DallasTemp 		pmDallasTemp;
Sck_DallasTemp 		dallasTemp;
Sck_SHT31 		sht31 = Sck_SHT31(&auxWire);
Sck_Range 		range;
Sck_BME680 		bme680;

// Eeprom flash emulation to store I2C address
FlashStorage(eepromAuxData, EepromAuxData);

bool AuxBoards::start(SensorType wichSensor)
{
	if (!dataLoaded) {
		data = eepromAuxData.read();
		dataLoaded = true;

		if (data.calibration.moistureCalDataValid) {
			moistureChirp.dryPoint = data.calibration.dryPoint;
			moistureChirp.wetPoint = data.calibration.wetPoint;
			moistureChirp.calibrated = true;
		}
	}

	switch (wichSensor) {

		case SENSOR_GASESBOARD_SLOT_1A:
		case SENSOR_GASESBOARD_SLOT_1W:
		case SENSOR_GASESBOARD_SLOT_2A:
		case SENSOR_GASESBOARD_SLOT_2W:
		case SENSOR_GASESBOARD_SLOT_3A:
		case SENSOR_GASESBOARD_SLOT_3W:
		case SENSOR_GASESBOARD_HUMIDITY:
		case SENSOR_GASESBOARD_TEMPERATURE: 	return gasBoard.start(); break;
		case SENSOR_GROOVE_I2C_ADC: 		return grooveI2C_ADC.start(); break;
		case SENSOR_INA219_BUSVOLT:
		case SENSOR_INA219_SHUNT:
		case SENSOR_INA219_CURRENT:
		case SENSOR_INA219_LOADVOLT: 		return ina219.start(); break;
		case SENSOR_GROOVE_OLED: 		return groove_OLED.start(); break;
		case SENSOR_WATER_TEMP_DS18B20:		return waterTemp_DS18B20.start(); break;
		case SENSOR_ATLAS_TEMPERATURE: 		return atlasTEMP.start(); break;
		case SENSOR_ATLAS_PH:			return atlasPH.start();
		case SENSOR_ATLAS_EC:
		case SENSOR_ATLAS_EC_SG: 		return atlasEC.start(); break;
		case SENSOR_ATLAS_DO:
		case SENSOR_ATLAS_DO_SAT: 		return atlasDO.start(); break;
		case SENSOR_CHIRP_MOISTURE_RAW:
		case SENSOR_CHIRP_MOISTURE:
		case SENSOR_CHIRP_TEMPERATURE:
		case SENSOR_CHIRP_LIGHT:		return moistureChirp.start(); break;
		case SENSOR_EXT_A_PM_1:
		case SENSOR_EXT_A_PM_25:
		case SENSOR_EXT_A_PM_10:
		case SENSOR_EXT_A_PN_03:
		case SENSOR_EXT_A_PN_05:
		case SENSOR_EXT_A_PN_1:
		case SENSOR_EXT_A_PN_25:
		case SENSOR_EXT_A_PN_5:
		case SENSOR_EXT_A_PN_10:
		case SENSOR_EXT_B_PM_1:
		case SENSOR_EXT_B_PM_25:
		case SENSOR_EXT_B_PM_10:
		case SENSOR_EXT_B_PN_03:
		case SENSOR_EXT_B_PN_05:
		case SENSOR_EXT_B_PN_1:
		case SENSOR_EXT_B_PN_25:
		case SENSOR_EXT_B_PN_5:
		case SENSOR_EXT_B_PN_10:
		case SENSOR_EXT_PM_1:
		case SENSOR_EXT_PM_25:
		case SENSOR_EXT_PM_10:
		case SENSOR_EXT_PN_03:
		case SENSOR_EXT_PN_05:
		case SENSOR_EXT_PN_1:
		case SENSOR_EXT_PN_25:
		case SENSOR_EXT_PN_5:
		case SENSOR_EXT_PN_10:			return pmSensor.start(); break;
		case SENSOR_PM_DALLAS_TEMP: 		return pmDallasTemp.start(); break;
		case SENSOR_DALLAS_TEMP: 		return dallasTemp.start(); break;
		case SENSOR_SHT31_TEMP:
		case SENSOR_SHT31_HUM:
			if (sht31.start() && !gasBoard.start()) return true;
			else return false;
			break;
		case SENSOR_RANGE_DISTANCE: 		return range.start(); break;
		case SENSOR_RANGE_LIGHT: 		return range.start(); break;
		case SENSOR_BME680_TEMPERATURE:		return bme680.start(); break;
		case SENSOR_BME680_HUMIDITY:		return bme680.start(); break;
		case SENSOR_BME680_PRESSURE:		return bme680.start(); break;
		case SENSOR_BME680_VOCS:		return bme680.start(); break;
		default: break;
	}

	return false;
}

bool AuxBoards::stop(SensorType wichSensor)
{
	switch (wichSensor) {

		case SENSOR_GASESBOARD_SLOT_1A:
		case SENSOR_GASESBOARD_SLOT_1W:
		case SENSOR_GASESBOARD_SLOT_2A:
		case SENSOR_GASESBOARD_SLOT_2W:
		case SENSOR_GASESBOARD_SLOT_3A:
		case SENSOR_GASESBOARD_SLOT_3W:
		case SENSOR_GASESBOARD_HUMIDITY:
		case SENSOR_GASESBOARD_TEMPERATURE: 	return gasBoard.stop(); break;
		case SENSOR_GROOVE_I2C_ADC: 		return grooveI2C_ADC.stop(); break;
		case SENSOR_INA219_BUSVOLT:
		case SENSOR_INA219_SHUNT:
		case SENSOR_INA219_CURRENT:
		case SENSOR_INA219_LOADVOLT: 		return ina219.stop(); break;
		case SENSOR_GROOVE_OLED: 		return groove_OLED.stop(); break;
		case SENSOR_WATER_TEMP_DS18B20:		return waterTemp_DS18B20.stop(); break;
		case SENSOR_ATLAS_TEMPERATURE: 		return atlasTEMP.stop(); break;
		case SENSOR_ATLAS_PH:			return atlasPH.stop();
		case SENSOR_ATLAS_EC:
		case SENSOR_ATLAS_EC_SG: 		return atlasEC.stop(); break;
		case SENSOR_ATLAS_DO:
		case SENSOR_ATLAS_DO_SAT: 		return atlasDO.stop(); break;
		case SENSOR_CHIRP_TEMPERATURE:
		case SENSOR_CHIRP_MOISTURE:		return moistureChirp.stop(); break;
		case SENSOR_EXT_A_PM_1:
		case SENSOR_EXT_A_PM_25:
		case SENSOR_EXT_A_PM_10:
		case SENSOR_EXT_A_PN_03:
		case SENSOR_EXT_A_PN_05:
		case SENSOR_EXT_A_PN_1:
		case SENSOR_EXT_A_PN_25:
		case SENSOR_EXT_A_PN_5:
		case SENSOR_EXT_A_PN_10:
		case SENSOR_EXT_B_PM_1:
		case SENSOR_EXT_B_PM_25:
		case SENSOR_EXT_B_PM_10:
		case SENSOR_EXT_B_PN_03:
		case SENSOR_EXT_B_PN_05:
		case SENSOR_EXT_B_PN_1:
		case SENSOR_EXT_B_PN_25:
		case SENSOR_EXT_B_PN_5:
		case SENSOR_EXT_B_PN_10:
		case SENSOR_EXT_PM_1:
		case SENSOR_EXT_PM_25:
		case SENSOR_EXT_PM_10:
		case SENSOR_EXT_PN_03:
		case SENSOR_EXT_PN_05:
		case SENSOR_EXT_PN_1:
		case SENSOR_EXT_PN_25:
		case SENSOR_EXT_PN_5:
		case SENSOR_EXT_PN_10:			return pmSensor.stop(); break;
		case SENSOR_PM_DALLAS_TEMP: 		return pmDallasTemp.stop(); break;
		case SENSOR_DALLAS_TEMP: 		return dallasTemp.stop(); break;
		case SENSOR_SHT31_TEMP:
		case SENSOR_SHT31_HUM: 			return sht31.stop(); break;
		case SENSOR_RANGE_DISTANCE: 		return range.stop(); break;
		case SENSOR_RANGE_LIGHT: 		return range.stop(); break;
		case SENSOR_BME680_TEMPERATURE:		return bme680.stop(); break;
		case SENSOR_BME680_HUMIDITY:		return bme680.stop(); break;
		case SENSOR_BME680_PRESSURE:		return bme680.stop(); break;
		case SENSOR_BME680_VOCS:		return bme680.stop(); break;
		default: break;
	}

	return false;
}

void AuxBoards::getReading(OneSensor *wichSensor)
{
	wichSensor->state = 0;
	switch (wichSensor->type) {
		case SENSOR_GASESBOARD_SLOT_1A:	 	wichSensor->reading = String(gasBoard.getElectrode(gasBoard.Slot1.electrode_A)); return;
		case SENSOR_GASESBOARD_SLOT_1W: 	wichSensor->reading = String(gasBoard.getElectrode(gasBoard.Slot1.electrode_W)); return;
		case SENSOR_GASESBOARD_SLOT_2A: 	wichSensor->reading = String(gasBoard.getElectrode(gasBoard.Slot2.electrode_A)); return;
		case SENSOR_GASESBOARD_SLOT_2W: 	wichSensor->reading = String(gasBoard.getElectrode(gasBoard.Slot2.electrode_W)); return;
		case SENSOR_GASESBOARD_SLOT_3A: 	wichSensor->reading = String(gasBoard.getElectrode(gasBoard.Slot3.electrode_A)); return;
		case SENSOR_GASESBOARD_SLOT_3W: 	wichSensor->reading = String(gasBoard.getElectrode(gasBoard.Slot3.electrode_W)); return;
		case SENSOR_GASESBOARD_HUMIDITY: 	wichSensor->reading = String(gasBoard.getHumidity()); return;
		case SENSOR_GASESBOARD_TEMPERATURE: 	wichSensor->reading = String(gasBoard.getTemperature()); return;
		case SENSOR_GROOVE_I2C_ADC: 		wichSensor->reading = String(grooveI2C_ADC.getReading()); return;
		case SENSOR_INA219_BUSVOLT: 		wichSensor->reading = String(ina219.getReading(ina219.BUS_VOLT)); return;
		case SENSOR_INA219_SHUNT: 		wichSensor->reading = String(ina219.getReading(ina219.SHUNT_VOLT)); return;
		case SENSOR_INA219_CURRENT: 		wichSensor->reading = String(ina219.getReading(ina219.CURRENT)); return;
		case SENSOR_INA219_LOADVOLT: 		wichSensor->reading = String(ina219.getReading(ina219.LOAD_VOLT)); return;
		case SENSOR_WATER_TEMP_DS18B20:		wichSensor->reading = String(waterTemp_DS18B20.getReading()); return;
		case SENSOR_ATLAS_TEMPERATURE: 		if (atlasTEMP.getReading()) 	{ wichSensor->reading = String(atlasTEMP.newReading); return; } break;
		case SENSOR_ATLAS_PH:			if (atlasPH.getReading()) 	{ wichSensor->reading = String(atlasPH.newReading); return; } break;
		case SENSOR_ATLAS_EC:			if (atlasEC.getReading()) 	{ wichSensor->reading = String(atlasEC.newReading); return; } break;
		case SENSOR_ATLAS_EC_SG:		if (atlasEC.getReading()) 	{ wichSensor->reading = String(atlasEC.newReadingB); return; } break;
		case SENSOR_ATLAS_DO:			if (atlasDO.getReading()) 	{ wichSensor->reading = String(atlasDO.newReading); return; } break;
		case SENSOR_ATLAS_DO_SAT:		if (atlasDO.getReading()) 	{ wichSensor->reading = String(atlasDO.newReadingB); return; } break;
		case SENSOR_CHIRP_MOISTURE_RAW:		if (moistureChirp.getReading(SENSOR_CHIRP_MOISTURE_RAW)) { wichSensor->reading = String(moistureChirp.raw); return; } break;
		case SENSOR_CHIRP_MOISTURE:		if (moistureChirp.getReading(SENSOR_CHIRP_MOISTURE)) { wichSensor->reading = String(moistureChirp.moisture); return; } break;
		case SENSOR_CHIRP_TEMPERATURE:		if (moistureChirp.getReading(SENSOR_CHIRP_TEMPERATURE)) { wichSensor->reading = String(moistureChirp.temperature); return; } break;
		case SENSOR_CHIRP_LIGHT:		if (moistureChirp.getReading(SENSOR_CHIRP_LIGHT)) { wichSensor->reading = String(moistureChirp.light); return; } break;
		case SENSOR_EXT_A_PM_1:
		case SENSOR_EXT_A_PM_25:
		case SENSOR_EXT_A_PM_10:
		case SENSOR_EXT_A_PN_03:
		case SENSOR_EXT_A_PN_05:
		case SENSOR_EXT_A_PN_1:
		case SENSOR_EXT_A_PN_25:
		case SENSOR_EXT_A_PN_5:
		case SENSOR_EXT_A_PN_10:		wichSensor->reading = String(pmSensor.getReading(SLOT_A, wichSensor->type)); return;
		case SENSOR_EXT_B_PM_1:
		case SENSOR_EXT_B_PM_25:
		case SENSOR_EXT_B_PM_10:
		case SENSOR_EXT_B_PN_03:
		case SENSOR_EXT_B_PN_05:
		case SENSOR_EXT_B_PN_1:
		case SENSOR_EXT_B_PN_25:
		case SENSOR_EXT_B_PN_5:
		case SENSOR_EXT_B_PN_10: 		wichSensor->reading = String(pmSensor.getReading(SLOT_B, wichSensor->type)); return;
		case SENSOR_EXT_PM_1:
		case SENSOR_EXT_PM_25:
		case SENSOR_EXT_PM_10:
		case SENSOR_EXT_PN_03:
		case SENSOR_EXT_PN_05:
		case SENSOR_EXT_PN_1:
		case SENSOR_EXT_PN_25:
		case SENSOR_EXT_PN_5:
		case SENSOR_EXT_PN_10: 			wichSensor->reading = String(pmSensor.getReading(SLOT_AVG, wichSensor->type)); return;
		case SENSOR_PM_DALLAS_TEMP: 		wichSensor->reading = String(pmDallasTemp.getReading()); return;
		case SENSOR_DALLAS_TEMP: 		if (dallasTemp.getReading()) 			{ wichSensor->reading = String(dallasTemp.reading); return; } break;
		case SENSOR_SHT31_TEMP: 		if (sht31.getReading()) 				{ wichSensor->reading = String(sht31.temperature); return; } break;
		case SENSOR_SHT31_HUM: 			if (sht31.getReading()) 				{ wichSensor->reading = String(sht31.humidity); return; } break;
		case SENSOR_RANGE_DISTANCE: 		if (range.getReading(SENSOR_RANGE_DISTANCE)) 	{ wichSensor->reading = String(range.readingDistance); return; } break;
		case SENSOR_RANGE_LIGHT: 		if (range.getReading(SENSOR_RANGE_LIGHT)) 	{ wichSensor->reading = String(range.readingLight); return; } break;
		case SENSOR_BME680_TEMPERATURE:		if (bme680.getReading()) 			{ wichSensor->reading = String(bme680.temperature); return; } break;
		case SENSOR_BME680_HUMIDITY:		if (bme680.getReading()) 			{ wichSensor->reading = String(bme680.humidity); return; } break;
		case SENSOR_BME680_PRESSURE:		if (bme680.getReading()) 			{ wichSensor->reading = String(bme680.pressure); return; } break;
		case SENSOR_BME680_VOCS:		if (bme680.getReading()) 			{ wichSensor->reading = String(bme680.VOCgas); return; } break;
		default: break;
	}

	wichSensor->reading = "null";
	wichSensor->state = -1;
}

bool AuxBoards::getBusyState(SensorType wichSensor)
{

	switch(wichSensor) {
		case SENSOR_GROOVE_OLED:	return true; break;
		case SENSOR_ATLAS_TEMPERATURE:  return atlasTEMP.getBusyState(); break;
		case SENSOR_ATLAS_PH: 		return atlasPH.getBusyState(); break;
		case SENSOR_ATLAS_EC:
		case SENSOR_ATLAS_EC_SG: 	return atlasEC.getBusyState(); break;
		case SENSOR_ATLAS_DO:
		case SENSOR_ATLAS_DO_SAT: 	return atlasDO.getBusyState(); break;
		default: return false; break;
	}
}

String AuxBoards::control(SensorType wichSensor, String command)
{
	switch(wichSensor) {
		case SENSOR_GASESBOARD_SLOT_1A:
		case SENSOR_GASESBOARD_SLOT_1W:
		case SENSOR_GASESBOARD_SLOT_2A:
		case SENSOR_GASESBOARD_SLOT_2W:
		case SENSOR_GASESBOARD_SLOT_3A:
		case SENSOR_GASESBOARD_SLOT_3W: {

			if (command.startsWith("set pot")) {

				Electrode wichElectrode;

				switch(wichSensor) {
					case SENSOR_GASESBOARD_SLOT_1A: wichElectrode = gasBoard.Slot1.electrode_A;
					case SENSOR_GASESBOARD_SLOT_1W: wichElectrode = gasBoard.Slot1.electrode_W;
					case SENSOR_GASESBOARD_SLOT_2A: wichElectrode = gasBoard.Slot2.electrode_A;
					case SENSOR_GASESBOARD_SLOT_2W: wichElectrode = gasBoard.Slot2.electrode_W;
					case SENSOR_GASESBOARD_SLOT_3A: wichElectrode = gasBoard.Slot3.electrode_A;
					case SENSOR_GASESBOARD_SLOT_3W: wichElectrode = gasBoard.Slot3.electrode_W;
					default: break;
				}

				command.replace("set pot", "");
				command.trim();
				int wichValue = command.toInt();
				gasBoard.setPot(wichElectrode, wichValue);
				return String F("Setting pot to: ") + String(wichValue) + F(" Ohms\n\rActual value: ") + String(gasBoard.getPot(wichElectrode)) + F(" Ohms");

			#ifdef gasesBoardTest
			} else if (command.startsWith("test")) {
				command.replace("test", "");
				command.trim();

				// Get slot
				String slotSTR = String(command.charAt(0));
				uint8_t wichSlot = slotSTR.toInt();

				command.remove(0,1);
				command.trim();

				if (command.startsWith("set")) {

					command.replace("set", "");
					command.trim();

					// Get value
					int wichValue = command.toInt();
					gasBoard.setTesterCurrent(wichValue, wichSlot);

				} else if (command.startsWith("full")) {

					gasBoard.runTester(wichSlot);

				} else {
					return F("Unrecognized test command!!\r\nOptions:\r\ntest slot set value (slot: 1-3, value:-1400/+1400 nA)\r\ntest slot full (test the full cycle on slot (1-3))");
				}

				return F("\nTesting finished!");

			} else if (command.startsWith("autotest")) {

				return String(gasBoard.autoTest());
			#endif

			} else if (command.startsWith("help")) {
				return F("Available commands for this sensor:\n\r* set pot ");

			} else {
				return F("Unrecognized command!! please try again...");
			}

			break;

		}
		case SENSOR_ATLAS_PH:
		case SENSOR_ATLAS_EC:
		case SENSOR_ATLAS_EC_SG:
		case SENSOR_ATLAS_DO:
		case SENSOR_ATLAS_DO_SAT: {

			Atlas *thisAtlas = &atlasPH;
			if (wichSensor == SENSOR_ATLAS_EC || wichSensor == SENSOR_ATLAS_EC_SG) thisAtlas = &atlasEC;
			else if (wichSensor == SENSOR_ATLAS_DO || wichSensor == SENSOR_ATLAS_DO_SAT) thisAtlas = &atlasDO;

			// 	 Calibration command options:
			// 		Atlas PH: (https://www.atlas-scientific.com/_files/_datasheets/_circuit/pH_EZO_datasheet.pdf) page 50
			// 			* set cal,[mid,low,high] 7.00
			// 			* set cal,clear
			// 		Atlas EC: (https://www.atlas-scientific.com/_files/_datasheets/_circuit/EC_EZO_Datasheet.pdf) page 52
			// 			* set cal,[dry,clear,84]
			// 			* set cal,low,1413
			// 			* set cal,high,12,880
			// 		Atlas DO: (https://www.atlas-scientific.com/_files/_datasheets/_circuit/DO_EZO_Datasheet.pdf) page 50
			// 			* set cal
			// 			* set cal,0
			// 			* set cal,clear
			if (command.startsWith("com")) {

				command.replace("com", "");
				command.trim();
				thisAtlas->sendCommand((char*)command.c_str());

				uint8_t responseCode = thisAtlas->getResponse();
				if (responseCode == 254) delay(1000); responseCode = thisAtlas->getResponse();
				if (responseCode == 1) return thisAtlas->atlasResponse;
				else return String(responseCode);

			}
			break;

		} case SENSOR_CHIRP_MOISTURE_RAW:
		case SENSOR_CHIRP_MOISTURE:
		case SENSOR_CHIRP_TEMPERATURE:
		case SENSOR_CHIRP_LIGHT: {

			if (command.startsWith("get ver")) {

				return String(moistureChirp.getVersion());

			} else if (command.startsWith("reset")) {

				for(uint8_t address = 1; address < 127; address++ ) {

					uint8_t error;
					auxWire.beginTransmission(address);

					if (auxWire.endTransmission() == 0) {
						if (moistureChirp.resetAddress(address)) return F("Changed chirp address to default 0x20");
					}
				}
				return F("Can't find any chirp sensor...");

			} else if (command.startsWith("cal")) {

				command.replace("cal", "");
				command.trim();

				int space_index = command.indexOf(" ");

				if (space_index > 0) {

					String preDry = command.substring(0, space_index);
					String preWet = command.substring(space_index + 1);

					int32_t dryInt = preDry.toInt();
					int32_t wetInt = preWet.toInt();

					if ((dryInt == 0 && preDry != "0") || (wetInt == 0 && preWet != "0")) return F("Error reading values, please try again!");

					moistureChirp.dryPoint = data.calibration.dryPoint = dryInt;
					moistureChirp.wetPoint = data.calibration.wetPoint = wetInt;
					data.calibration.moistureCalDataValid = true;
					moistureChirp.calibrated = true;

					data.valid = true;
					eepromAuxData.write(data);
				}

				String response;
				if (moistureChirp.calibrated) {
					response += "Dry point: " + String(moistureChirp.dryPoint) + "\r\nWet point: " + String(moistureChirp.wetPoint);
				} else {
					response = F("Moisture sensor is NOT calibrated");
				}
				return response;


			} else if (command.startsWith("help") || command.length() == 0) return F("Available commands:\r\n* get ver\r\n* reset (connect only the chirp to aux)\r\n* cal dryPoint wetPoint");
			else return F("Unrecognized command!! please try again...");
			break;

		} case SENSOR_EXT_PM_1:
		case SENSOR_EXT_PM_25:
		case SENSOR_EXT_PM_10: {

			if (command.startsWith("stop")) {

				if (pmSensor.stop()) return ("Stoping PM sensors...");
				else return ("Failed stoping PM sensor!!");

			} else if (command.startsWith("start")) {

				if (pmSensor.start()) return ("Starting PM sensors...");
				else return ("Failed starting PM sensor!!");

			}
			break;
		} default: return "Unrecognized sensor!!!"; break;
	}
	return "Unknown error on control command!!!";
}

void AuxBoards::print(SensorType wichSensor, String payload)
{

	groove_OLED.print(payload);
}

void AuxBoards::displayReading(String title, String reading, String unit, String time)
{

	groove_OLED.displayReading(title, reading, unit, time);
}

bool GrooveI2C_ADC::start()
{

	if (!I2Cdetect(&auxWire, deviceAddress)) return false;

	auxWire.beginTransmission(deviceAddress);		// transmit to device
	auxWire.write(REG_ADDR_CONFIG);				// Configuration Register
	auxWire.write(0x20);
	auxWire.endTransmission();
	return true;
}

bool GrooveI2C_ADC::stop()
{

	return true;
}

float GrooveI2C_ADC::getReading()
{

	uint32_t data = 0;

	auxWire.beginTransmission(deviceAddress);		// transmit to device
	auxWire.write(REG_ADDR_RESULT);				// get result
	auxWire.endTransmission();

	auxWire.requestFrom(deviceAddress, 2);			// request 2byte from device
	delay(1);

	if (auxWire.available()<=2) {
		data = (auxWire.read()&0x0f)<<8;
		data |= auxWire.read();
	}

	return data * V_REF * 2.0 / 4096.0;
}

bool INA219::start()
{

	if (!I2Cdetect(&auxWire, deviceAddress)) return false;

	ada_ina219.begin(&auxWire);

	// By default the initialization will use the largest range (32V, 2A).
	ada_ina219.setCalibration_32V_1A();
	// ada_ina219.setCalibration_16V_400mA();

	return true;
}

bool INA219::stop()
{
	// TODO check if there is a way to minimize power consumption
	return true;
}

float INA219::getReading(typeOfReading wichReading)
{

	switch(wichReading) {
		case BUS_VOLT: {

			return ada_ina219.getBusVoltage_V();
			break;

		} case SHUNT_VOLT: {

			return ada_ina219.getShuntVoltage_mV();
			break;

		} case CURRENT: {

			return ada_ina219.getCurrent_mA();
			break;

		} case LOAD_VOLT: {

			float busvoltage 	= ada_ina219.getBusVoltage_V();
			float shuntvoltage 	= ada_ina219.getShuntVoltage_mV();

			return busvoltage + (shuntvoltage / 1000);
			break;

		}
	}

	return 0;
}

bool Groove_OLED::start()
{
	if (!I2Cdetect(&auxWire, deviceAddress)) return false;

	U8g2_oled.begin();
	U8g2_oled.clearDisplay();

	U8g2_oled.firstPage();
	do { U8g2_oled.drawXBM( 0, 0, 96, 96, scLogo); } while (U8g2_oled.nextPage());

	return true;;
}

bool Groove_OLED::stop()
{

	return true;
}

void Groove_OLED::print(String payload)
{

	// uint8_t length = payload.length();
	char charPayload[payload.length()];
	payload.toCharArray(charPayload, payload.length()+1);

	U8g2_oled.firstPage();

	do {
		U8g2_oled.setFont(u8g2_font_ncenB14_tr);
		U8g2_oled.drawStr(0,24, charPayload);
	} while (U8g2_oled.nextPage());
}

void Groove_OLED::displayReading(String title, String reading, String unit, String time)
{

	String date;
	String hour;

	if (time.toInt() != 0) {
		date = time.substring(8,10) + "/" + time.substring(5,7) + "/" + time.substring(2,4);
		hour = time.substring(11,16);
	}

	U8g2_oled.firstPage();
	do {

		// Title
		U8g2_oled.setFont(u8g2_font_helvB10_tf);
		if (U8g2_oled.getStrWidth(title.c_str()) > 96 && title.indexOf(" ") > -1) {

			String first = title.substring(0, title.indexOf(" "));
			String second = title.substring(title.indexOf(" ")+1);

			U8g2_oled.drawStr((96-U8g2_oled.getStrWidth(first.c_str()))/2,11, first.c_str());
			U8g2_oled.drawStr((96-U8g2_oled.getStrWidth(second.c_str()))/2,23, second.c_str());

		} else U8g2_oled.drawStr((96-U8g2_oled.getStrWidth(title.c_str()))/2,11, title.c_str());

		// Reading
		U8g2_oled.setFont(u8g2_font_helvB24_tf);
		if (U8g2_oled.getStrWidth(reading.c_str()) > 96) U8g2_oled.setFont(u8g2_font_helvB18_tf);
		U8g2_oled.drawStr((96-U8g2_oled.getStrWidth(reading.c_str()))/2, 55,  reading.c_str());

		// Unit
		U8g2_oled.setFont(u8g2_font_helvB12_tf);
		U8g2_oled.drawStr((96-U8g2_oled.getStrWidth(unit.c_str()))/2,75, unit.c_str());

		if (time.toInt() != 0) {

			// Date
			U8g2_oled.setFont(u8g2_font_helvB10_tf);
			U8g2_oled.drawStr(0,96,date.c_str());

			// Time
			U8g2_oled.drawStr(96-U8g2_oled.getStrWidth(hour.c_str()),96,hour.c_str());
			U8g2_oled.drawStr(96-U8g2_oled.getStrWidth(hour.c_str()),96,hour.c_str());
		}

	} while (U8g2_oled.nextPage());
}

bool WaterTemp_DS18B20::start()
{

	if (!I2Cdetect(&auxWire, deviceAddress)) return false;

	auxWire.begin();

	DS_bridge.reset();
	DS_bridge.wireReset();
	DS_bridge.wireSkip();
	DS_bridge.wireWriteByte(0x44);

	detected = true;

	return true;
}

bool WaterTemp_DS18B20::stop()
{
	return true;
}

float WaterTemp_DS18B20::getReading()
{

 	while ( !DS_bridge.wireSearch(addr)) {

		DS_bridge.wireResetSearch();
		DS_bridge.wireReset();
		DS_bridge.selectChannel(0); 			// After reset need to set channel 0 because we are using the version with single channel (DS2482_100)
		DS_bridge.configure(conf);
 		DS_bridge.wireSkip();
 		DS_bridge.configure(conf); 				// Set bus on strong pull-up after next write, not only LSB nibble is required
 		DS_bridge.wireWriteByte(0x44); 			// Convert temperature on all devices
 		DS_bridge.configure(0x01);

	}

	//	Test if device is in reality the DS18B20 Water Temperature
	if (addr[0]==0x28) {

		// Read temperature data.
		DS_bridge.wireReset(); 				//DS_bridge.reset();
		DS_bridge.selectChannel(0); 		//necessary on -800
		DS_bridge.wireSelect(addr);
		DS_bridge.wireWriteByte(0xbe);      // Read Scratchpad command

		// We need to read 9 bytes
		for ( int i = 0; i < 9; i++) data[i] = DS_bridge.wireReadByte();

		// Convert to decimal temperature
		int LowByte = data[0];
		int HighByte = data[1];
		int TReading = (HighByte << 8) + LowByte;
		int SignBit = TReading & 0x8000;

		// If Temperature is negative
		if (SignBit) TReading = (TReading ^ 0xffff) + 1;

		int Tc_100 = (double)TReading * 0.0625 * 10;

		// If the reading is negative make it efective
		if (SignBit) Tc_100 = 0 - Tc_100;

		return ((float)(Tc_100) / 10) + 1;
	}

	return 0;
}

bool Atlas::start()
{

	if (!I2Cdetect(&auxWire, deviceAddress)) return false;

	if (beginDone) return true;
	beginDone = true;

	// Protocol lock
	if (!sendCommand((char*)"Plock,1")) return false;
	delay(shortWait);

	// This actions are only for conductivity (EC) sensor
	if (EC) {

		// Set probe
		if (!sendCommand((char*)"K,1.0")) return false;
		delay(shortWait);

		// ----  Set parameters
		if (sendCommand((char*)"O,?")) {
			delay(shortWait);
			if (!atlasResponse.equals("?O,EC,SG")) {
				const char *parameters[4] = PROGMEM {"O,EC,1", "O,TDS,0", "O,S,0", "O,SG,1"};
				for (int i = 0; i<4; ++i) {
					if (!sendCommand((char*)parameters[i])) return false;
					delay(longWait);
				}
			}
		} else return false;

	} else if (DO) {

		// ---- Set parameters
		if (sendCommand((char*)"O,?")) {
			delay(shortWait);
			if (!atlasResponse.equals((char*)"?O,%,mg")) {
				if (!sendCommand((char*)"O,%,1")) return false;
				delay(shortWait);
				if (!sendCommand((char*)"O,mg,1")) return false;
				delay(shortWait);
			}
		} else return false;
	}

	detected = true;

	goToSleep();

	return true;
}

bool Atlas::stop()
{
	return true;
}

bool Atlas::getReading()
{

	if (millis() - lastUpdate < 2000) return true;
	uint32_t started = millis();
	while (getBusyState()) {
		if (millis() - started > 5000) return false; 	// Timeout
		delay(2);
	}
	return true;
}

bool Atlas::getBusyState()
{

	if (millis() - lastUpdate < 2) return true;
	switch (state) {

		case REST: {

			if (TEMP) {
				state = TEMP_COMP_SENT;
				break;
			}

			if (tempCompensation()) state = TEMP_COMP_SENT;
			break;

		} case TEMP_COMP_SENT: {

			if (millis() - lastCommandSent >= shortWait) {
				if (sendCommand((char*)"r")) state = ASKED_READING;
			}
			break;

		} case ASKED_READING: {

		   	uint16_t customWait = longWait;
			if (TEMP) customWait = mediumWait;

			if (millis() - lastCommandSent >= customWait) {

				uint8_t code = getResponse();

				if (code == 254) {
					// Still working (wait a little more)
					lastCommandSent = lastCommandSent + 200;
					break;

				} else if (code == 1) {

					// Reading OK
					state = REST;

					if (PH || TEMP)	newReading = atlasResponse.toFloat();
					if (EC || DO) {
						String first = atlasResponse.substring(0, atlasResponse.indexOf(","));
						String second = atlasResponse.substring(atlasResponse.indexOf(",")+1);
						newReading = first.toFloat();
						newReadingB = second.toFloat();
					}
					goToSleep();
					return false;
					break;

				} else {

					// Error
					state = REST;
					newReading = 0;
					goToSleep();
					return false;
					break;
				}
			}
			break;
		}
	}

	lastUpdate = millis();
	return true;
}

void Atlas::goToSleep()
{

	auxWire.beginTransmission(deviceAddress);
	auxWire.write("Sleep");
	auxWire.endTransmission();
}

bool Atlas::sendCommand(char* command)
{

	uint8_t retrys = 5;

	for (uint8_t i=0; i<retrys; ++i) {

		auxWire.beginTransmission(deviceAddress);
		auxWire.write(command);

		auxWire.requestFrom(deviceAddress, 1, true);
		uint8_t confirmed = auxWire.read();
		auxWire.endTransmission();

		if (confirmed == 1) {
			lastCommandSent = millis();
			return true;
		}

		delay(300);
	}
	return false;
}

bool Atlas::tempCompensation()
{
	String stringData;
	char data[10];
	float temperature = 0;

	if (waterTemp_DS18B20.detected) temperature = waterTemp_DS18B20.getReading();
	else if (atlasTEMP.detected) {

		if (millis() - atlasTEMP.lastUpdate > 10000) {
			while (atlasTEMP.getBusyState()) delay(2);
		}

		temperature = atlasTEMP.newReading;
	} else {

		// No available sensor for temp compensation
		// Still we want the readings
		return true;
	}

	// Error on reading temperature
	if (temperature == 0) return false;

	sprintf(data,"T,%.2f",temperature);
	if (sendCommand(data)) return true;

	return false;
}

uint8_t Atlas::getResponse()
{

	uint8_t code;

	auxWire.requestFrom(deviceAddress, 20, 1);
	uint32_t time = millis();
	while (!auxWire.available()) if ((millis() - time)>500) return 0x00;
	code = auxWire.read();

	atlasResponse = "";

	switch (code) {
		case 0: 		// Undefined
		case 2:			// Error
		case 255:		// No data sent
		case 254: {		// Still procesing, not ready

			return code;
			break;

		} default : {

			while (auxWire.available()) {
				char buff = auxWire.read();
				atlasResponse += buff;
			}
			auxWire.endTransmission();

			if (atlasResponse.length() > 0) {
				return 1;
			}

			return 2;
		}
    }
}

bool Moisture::start()
{
	if (!I2Cdetect(&auxWire, deviceAddress)) return false;
	if (alreadyStarted) return true;

	chirp.begin();

	alreadyStarted = true;

	detected = true;

	return true;
}

bool Moisture::stop()
{
	return true;
}

bool Moisture::getReading(SensorType wichSensor)
{
	uint32_t started = millis();
	while (chirp.isBusy()) {
		if (millis() - started > 5000) return 0; 	// Timeout
		delay(1);
	}

	switch(wichSensor) {
		case SENSOR_CHIRP_MOISTURE_RAW: {

			raw = chirp.getCapacitance();
			return true;

		} case SENSOR_CHIRP_MOISTURE: {

			if (!calibrated) return false;
			int32_t thisValue = chirp.getCapacitance();
			moisture = map(thisValue, dryPoint, wetPoint, 0.0, 100.0);
			return true;

		} case SENSOR_CHIRP_TEMPERATURE: {

			temperature = chirp.getTemperature() / 10.0;
			return true;

		} case SENSOR_CHIRP_LIGHT: {

			// From Arduino library documentation
			// The measurement gives 65535 in a dark room away form desk lamp - so more light, lower reading.

			light = chirp.getLight(false); 		// We are sending the reading from previous request
			chirp.startMeasureLight(); 		// Ask for next reading
			return true;

		} default: break;
	}

	return false;
}

uint8_t Moisture::getVersion()
{

	return chirp.getVersion();
}

void Moisture::sleep()
{

	chirp.sleep();
}

bool Moisture::resetAddress(int currentAddress)
{
	chirp.changeSensor(currentAddress, true);
	return chirp.setAddress(0x20, true);
}

bool PMsensor::start()
{
	if (started) return true;

	if (!I2Cdetect(&auxWire, deviceAddress) || failed) return false;

	auxWire.beginTransmission(deviceAddress);
	auxWire.write(PM_START);
	auxWire.endTransmission();
	auxWire.requestFrom(deviceAddress, 1);

	bool result = auxWire.read();

	if (result == 0) failed = true;
	else started = true;

	return result;
}

bool PMsensor::stop()
{

	if (!I2Cdetect(&auxWire, deviceAddress)) return false;

	auxWire.beginTransmission(deviceAddress);
	auxWire.write(PM_STOP);
	auxWire.endTransmission();

	started = false;
	return true;
}

float PMsensor::getReading(PMslot slot, SensorType wichSensor)
{
	if (millis() - lastReading > 1000 || lastSlot != slot) {
		// Ask for reading
		auxWire.beginTransmission(deviceAddress);
		switch (slot) {
			case SLOT_A: auxWire.write(GET_PMA); break;
			case SLOT_B: auxWire.write(GET_PMB); break;
			case SLOT_AVG: auxWire.write(GET_PM_AVG); break;
		}
		auxWire.endTransmission();
		delay(2);

		// Get the reading
		auxWire.requestFrom(deviceAddress, valuesSize);
		uint32_t time = millis();
		while (!auxWire.available()) if ((millis() - time)>500) return 0x00;

		bool isError = true;
		for (uint8_t i=0; i<valuesSize; i++) {
			values[i] = auxWire.read();
			if (values[i] != 255) isError = false;
		}

		if (isError) return -9999;

		pm1 = (values[0]<<8) + values[1];
		pm25 = (values[2]<<8) + values[3];
		pm10 = (values[4]<<8) + values[5];
		pn03 = (values[6]<<8) + values[7];
		pn05 = (values[8]<<8) + values[9];
		pn1 = (values[10]<<8) + values[11];
		pn25 = (values[12]<<8) + values[13];
		pn5 = (values[14]<<8) + values[15];
		pn10 = (values[16]<<8) + values[17];

		lastReading = millis();
		lastSlot = slot;
	}


	switch(wichSensor) {
		case SENSOR_EXT_PM_1:
		case SENSOR_EXT_A_PM_1:
		case SENSOR_EXT_B_PM_1: return pm1; break;
		case SENSOR_EXT_PM_25:
		case SENSOR_EXT_A_PM_25:
		case SENSOR_EXT_B_PM_25: return pm25; break;
		case SENSOR_EXT_PM_10:
		case SENSOR_EXT_A_PM_10:
		case SENSOR_EXT_B_PM_10: return pm10; break;
		case SENSOR_EXT_PN_03:
		case SENSOR_EXT_A_PN_03:
		case SENSOR_EXT_B_PN_03: return pn03; break;
		case SENSOR_EXT_PN_05:
		case SENSOR_EXT_A_PN_05:
		case SENSOR_EXT_B_PN_05: return pn05; break;
		case SENSOR_EXT_PN_1:
		case SENSOR_EXT_A_PN_1:
		case SENSOR_EXT_B_PN_1: return pn1; break;
		case SENSOR_EXT_PN_25:
		case SENSOR_EXT_A_PN_25:
		case SENSOR_EXT_B_PN_25: return pn25; break;
		case SENSOR_EXT_PN_5:
		case SENSOR_EXT_A_PN_5:
		case SENSOR_EXT_B_PN_5: return pn5; break;
		case SENSOR_EXT_PN_10:
		case SENSOR_EXT_A_PN_10:
		case SENSOR_EXT_B_PN_10: return pn10; break;
		default:break;
	}

	return -9999;
}

bool PM_DallasTemp::start()
{
	if (!I2Cdetect(&auxWire, deviceAddress)) return false;

	auxWire.beginTransmission(deviceAddress);
	auxWire.write(DALLASTEMP_START);
	auxWire.endTransmission();
	auxWire.requestFrom(deviceAddress, 1);

	bool result = auxWire.read();
	return result;
}

bool PM_DallasTemp::stop()
{
	if (!I2Cdetect(&auxWire, deviceAddress)) return false;

	auxWire.beginTransmission(deviceAddress);
	auxWire.write(DALLASTEMP_STOP);
	auxWire.endTransmission();
	auxWire.requestFrom(deviceAddress, 1);

	bool result = auxWire.read();
	return result;
}

float PM_DallasTemp::getReading()
{
	if (!I2Cdetect(&auxWire, deviceAddress)) return false;

	auxWire.beginTransmission(deviceAddress);
	auxWire.write(GET_DALLASTEMP);
	auxWire.endTransmission();

	// Get the reading
	auxWire.requestFrom(deviceAddress, 4);
	uint32_t start = millis();
	while (!auxWire.available()) if ((millis() - start)>500) return -9999;
	for (uint8_t i=0; i<4; i++) uRead.b[i] = auxWire.read();
	return uRead.fval;
}

bool Sck_DallasTemp::start()
{
	pinPeripheral(pinAUX_WIRE_SCL, PIO_DIGITAL);
	OneWire oneWire = OneWire(pinAUX_WIRE_SCL);
	DallasTemperature _dallasTemp = DallasTemperature(&oneWire);

	_dallasTemp.begin();

	// If no device is found return false
	_dallasTemp.getAddress(_oneWireAddress, 0);

	_dallasTemp.setResolution(12);
	_dallasTemp.setWaitForConversion(true);

	if (!getReading()) return false;

	pinPeripheral(pinAUX_WIRE_SCL, PIO_SERCOM);

	return true;
}

bool Sck_DallasTemp::stop()
{

	return true;
}

bool Sck_DallasTemp::getReading()
{
	pinPeripheral(pinAUX_WIRE_SCL, PIO_DIGITAL);
	OneWire oneWire = OneWire(pinAUX_WIRE_SCL);
	DallasTemperature _dallasTemp = DallasTemperature(&oneWire);

	_dallasTemp.requestTemperatures();
	reading = _dallasTemp.getTempC(_oneWireAddress);
	if (reading <= DEVICE_DISCONNECTED_C) return false;

	pinPeripheral(pinAUX_WIRE_SCL, PIO_SERCOM);

	return true;
}

bool Sck_Range::start()
{
	if (alreadyStarted) return true;

	if(vl6180x.VL6180xInit() != 0) return false;

	vl6180x.VL6180xDefautSettings();

	alreadyStarted = true;

	return true;
}

bool Sck_Range::stop()
{
	alreadyStarted = false;
	return true;
}

bool Sck_Range::getReading(SensorType wichSensor)
{
	switch(wichSensor)
{
	case SENSOR_RANGE_DISTANCE:
		readingDistance = vl6180x.getDistance();
		break;
	case SENSOR_RANGE_LIGHT:
		readingLight = vl6180x.getAmbientLight(GAIN_1);
		break;
	default:
		return false;
}
	return true;
}

bool Sck_BME680::start()
{
	if (alreadyStarted) return true;

	if (!bme.begin(deviceAddress)) return false;

	alreadyStarted = true;
	return true;
}

bool Sck_BME680::stop()
{
	alreadyStarted = false;
	return true;
}

bool Sck_BME680::getReading()
{
	if (millis() - lastTime > minTime) {
		if (!bme.performReading()) return false;
		lastTime = millis();
	}

	temperature = bme.temperature;
	humidity = bme.humidity;
	pressure = bme.pressure / 1000;  // Converted to kPa
	VOCgas = bme.gas_resistance;

	return true;
}

void writeI2C(byte deviceaddress, byte instruction, byte data )
{
  auxWire.beginTransmission(deviceaddress);
  auxWire.write(instruction);
  auxWire.write(data);
  auxWire.endTransmission();
}

byte readI2C(byte deviceaddress, byte instruction)
{
  byte  data = 0x0000;
  auxWire.beginTransmission(deviceaddress);
  auxWire.write(instruction);
  auxWire.endTransmission();
  auxWire.requestFrom(deviceaddress,1);
  unsigned long time = millis();
  while (!auxWire.available()) if ((millis() - time)>500) return 0x00;
  data = auxWire.read();
  return data;
}
