viric/smartcitizen-kit-21/(commit log)

2020-02-14 Routed SAM pin PA28 to CCS811 WAKE pin to allow sleep mode
    [SCK_URBAN_SHIELD_2.1rev_a.sch]
2020-05-15 Update the css811 driver to 2.0.1
2020-05-16 Fix lastBaselineWrite on rtc set
    It was saving after 20min - wrong.
    [SckBase.cpp]
2020-05-16 Report FWApp version of CCS811
    My device says:
    SCK > control eCO status
    eCO2 Gas CCS811: status
    fw app version: 1.0.0
    mode: 3
    getBaseline: 0xfeff
    error register: 0x2
    compensate: true
    [SckUrban.cpp, SckUrban.h]
2020-05-16 Read error better for CSS811
    [SckUrban.cpp, SckUrban.h]
2020-05-16 Fix css811 fwapp version read
    So 1.0.0 was wrong. I was not reading it ok.
    I flashed 2.0.1 before I could read my previous fw_app_version.
    [SckUrban.cpp]
2020-05-17 Save baseline on 2 seconds button.
    It was being 'saved' on reset, after deep sleep.
    [SckBase.cpp, SckButton.cpp]
2020-05-17 fix parsing of sensor title in sensor command
    [Commands.cpp]
2020-05-17 Fix setting of baseline if missing
    [SckBase.cpp]
